alelucrod/Perfusion/1.Memoria/imágenes/marcar segunda casilla al instalar python.JPG

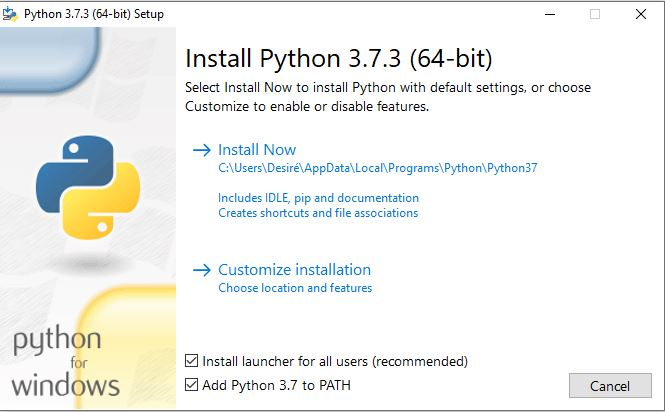
1.Memoria/imágenes/marcar segunda casilla al instalar python.JPG
