alelucrod/Perfusion/1.Memoria/Memoria Alberto/tfg_memoria_05.pdf

# Proyecto Fin de Grado Grado en Ingeniería de las Tecnologías Industriales

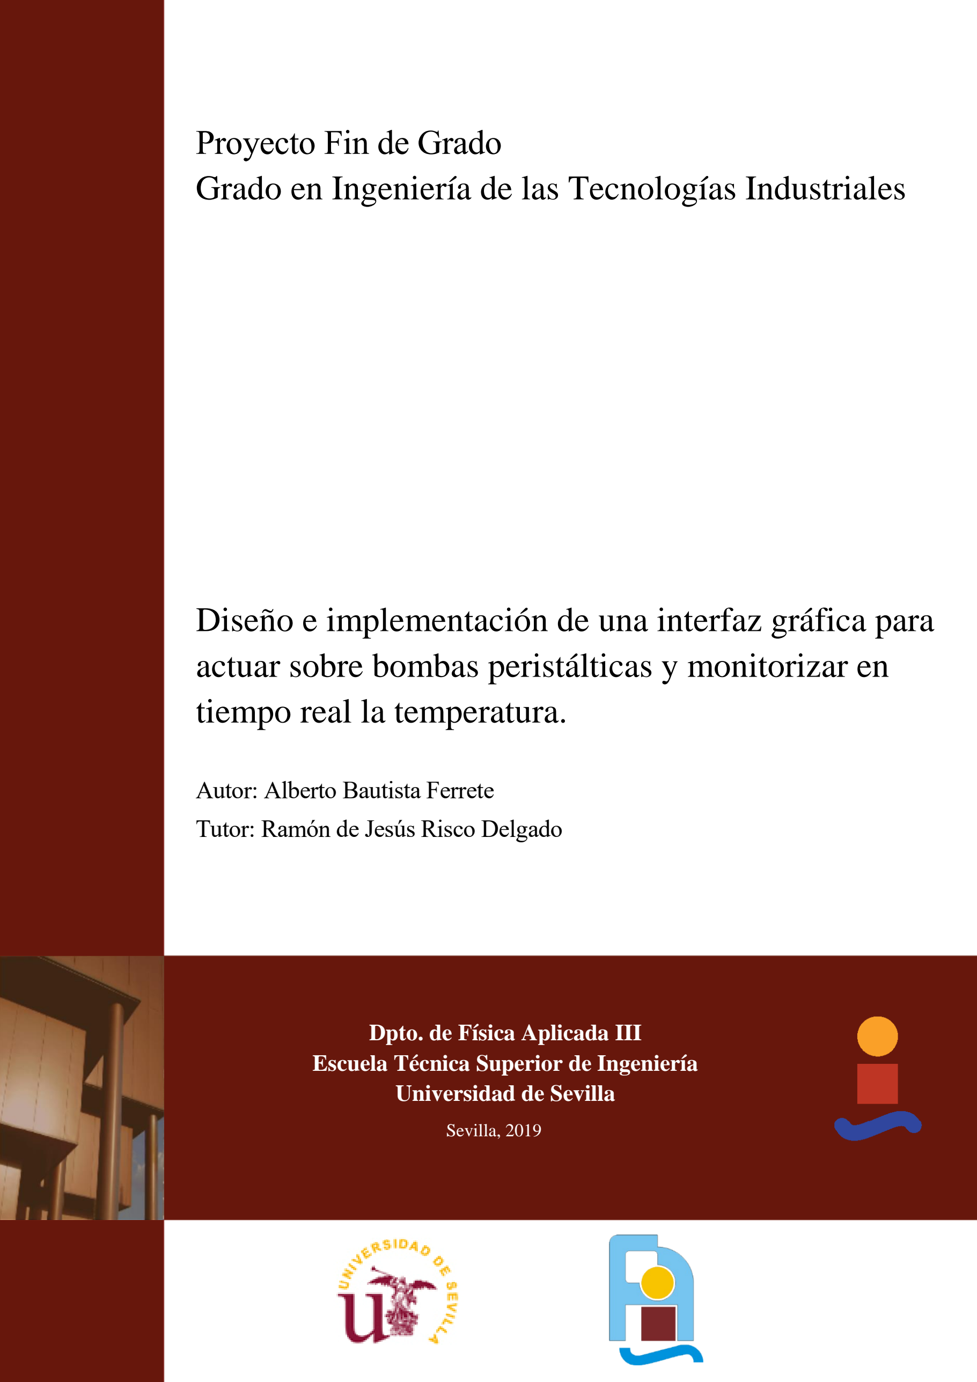
[picture p49: page 1]

Equation Chapter 1 Section 1

# Diseño e implementación de una interfaz gráfica para actuar sobre bombas peristálticas y monitorizar en

tiempo real la temperatura.

## Autor: Alberto Bautista Ferrete

## Tutor: Ramón de Jesús Risco Delgado

### Dpto. de Física Aplicada III Escuela Técnica Superior de Ingeniería Universidad de Sevilla

Sevilla, 2019

## Proyecto Fin de Grado Grado en Ingeniería de las Tecnologías Industriales

# Diseño e implementación de una interfaz gráfica para actuar sobre bombas peristálticas y

monitorizar en tiempo real la temperatura.

Autor:

Alberto Bautista Ferrete

Tutor:

Ramón de Jesús Risco Delgado

Profesor titular

## Dpto. de Física Aplicada III

## Escuela Técnica Superior de Ingeniería

## Universidad de Sevilla

Sevilla, 2019

Proyecto Fin de Grado: Diseño e implementación de una interfaz gráfica para actuar sobre bombas peristálticas y monitorizar en tiempo real la temperatura.

Autor: Alberto Bautista ferrete

Tutor: Ramón de Jesús Risco Delgado

El tribunal nombrado para juzgar el Proyecto arriba indicado, compuesto por los siguientes miembros:

Presidente:

Vocales:

Secretario:

Acuerdan otorgarle la calificación de:

Sevilla, 2019

El Secretario del Tribunal

A mis padres y hermano.

A mis amigos.

A N.P.J.D.G.P

# Agradecimientos

En primer lugar, me gustaría mencionar a Alejandro Lucas Rodríguez por su dedicación, enseñanza y gran paciencia que ha mostrado. Siempre ha estado al servicio de lo que necesitase y ha facilitado a elaboración de este trabajo.

También he de agradecer a Ramón Risco Delgado y al personal del laboratorio L4 de la ETSI por las facilidades y los servicios prestados a la hora de utilizar el laboratorio.

Durante todo el tiempo invertido durante mis estudios universitarios he aprendido conceptos de cada una de las materias que los diferentes profesores me han impartido, pero sobre todo me han formado como persona aportándome una gran madurez y una visión diferente del mundo ingenieril. A ellos también mi sincero agradecimiento.

Acabo estás líneas agradeciendo a mis padres el sufrimiento en silencio que han sabido llevar durante todos estos años, a mi hermano que siempre ha estado atento a mí y a mis amigos que me han visto sufrir pero que siempre han conseguido sacarme una sonrisa y evadirme en los momentos más duros de la carrera.

Alberto Bautista Ferrete

Sevilla, 2019

# Resumen

Con el siguiente trabajo se pretende ayudar y facilitar la experimentación con criopreservación al personal del laboratorio que utiliza un par de bombas peristálticas de interés en Medicina y Biotecnología mediante una interfaz gráfica.

Este proyecto es la renovación de uno existente que se ha venido utilizando en el laboratorio, pero que ha quedado obsoleto tecnológicamente ya que el software implementado sólo es capaz de ejecutarse en un sistema operativo antiguo y con un hardware muy limitado.

Con este fin, se propone como solución la creación de una interfaz gráfica de usuario que agilice las pruebas de laboratorio y sea interactiva para que los investigadores y alumnado no tengan que aprender conceptos informáticos complejos para poderla utilizar.

Entre las diferentes características que en él se pueden encontrar, destacan las siguientes especificaciones que debe de cumplir este trabajo fin de grado.

- Escalable: cualquier alumno que quiera mejorar este trabajo añadiendo nuevas funcionalidades puede hacerlo sin tener grandes conocimientos sobre software informático y electrónica.
- Moduralizado: en el ámbito de la electrónica se han utilizado dispositivos (módulos) independientes que pueden ser reemplazados y cuyas funcionalidades están separadas del resto, por lo que, si se estropea o se produce algún fallo en cualquiera de los módulos, no inutiliza a los demás.
- Software libre: no se ha utilizado ningún software ni licencias de pago del que no se tiene conocimientos para su uso.
- Amplia comunidad: al disponer de un software libre cualquier persona iniciada o que se esté iniciando en programación puede encontrar ayuda o soluciones por parte de la comunidad en foros. Siempre es mejor desarrollar conjuntamente que de forma independiente.

Bajo estas premisas se ha conseguido actualizar el sistema del que se disponía, adaptarlo a futuras mejoras y certificar su validez de funcionamiento.

Para llevarlo a cabo, se realizará el diseño y construcción de una placa electrónica capaz de recopilar un amplio espectro de temperaturas y, a su vez, actuar sobre el caudal de una sustancia líquida que fluye por una serie de bombas peristálticas.

A continuación, y ligado con lo anterior, se implementará un software con una interfaz gráfica que facilite la actuación sobre las bombas, la monitorización de las temperaturas y el cambio de parámetros.

Para finalizar, este trabajo fin de grado se ha elaborado de tal modo que cualquier alumno interesado en un tfg, con características similares a este, pueda continuar mejorando y actualizando la interfaz gráfica, implementando nuevas funcionalidades.

# Abstract

The following project is intended to help and facilitate experimentation with cryopreservation to laboratory staff using a pair of peristaltic pumps of interest in Medicine and Biotechnology through a graphic interface.

This project is the renovation of an existing one that has been used in the laboratory, but which has become technologically obsolete since the software implemented is only capable of running on an old operating system and with very limited hardware.

To this purpose, it is proposed the creation of a graphical user interface that speeds up laboratory tests and is making it interactive so that researchers and students would not have to study complex computer concepts in order to use it

Among the different characteristics that can be found in it, the following specifications about this TFG must be highlighted.:

- Scalable: any student who wants to improve this work by adding new features can do so without having great knowledge about computer and electronic software.
- Modified: in the field of electronics devices, which have been used that can be replaced and whose functionalities are separated from the rest, so if it breaks down or a fault occurs in any of the modules, it does not disable others.
- Free software: no software or paid licenses have been used for which there is no knowledge for its use.
- Large community: by having free software any person initiated or who is starting in programming can find help or solutions from the community in forums. It is always better to develop together than independently.

Under these premises it has been possible to update the system that was available, adapt it to future improvements and certify its operational validity.

To carry it out, an electronic board will be designed and constructed being capable of compiling a wide spectrum of temperatures and, in turn, acting on the flow rate of a liquid substance flowing through a series of peristaltic pumps will be carried out.

Related to what has been mentioned above, a software with a graphical interface will be also implemented to facilitates the operation on the pumps, the monitoring of the temperatures and the change of parameters.

Finally, this TFG has been developed in such a way that any student interested in a TFG, with similar characteristics to this, can continue improving and updating the graphic interface, idding new functionalities.

# Índice

Agradecimientos | ix
Resumen | xi
Abstract | i
Índice | iii
Índice de Tablas | v
Índice de Figuras | vii
Notación | ix
1 | Introducción | 1
1.1 Criopreservación | 1
1.2 | Objetivo | 1
2 | Hardware | 5
2.1 | Componentes | 5
2.1.1 | Raspberry Pi 3: modelo B+ | 5
2.1.2 | Módulo MCP4725 | 6
2.1.3 | Módulo relé de 2 canales | 7
2.1.4 | Buzzer | 8
2.1.5 | Termopar Adafruit MAX31856 tipo K | 8
2.1.6 | Bidireccional | 9
2.2 | Fabricación de PCB | 10
2.2.1 | Pruebas iniciales | 10
2.2.2 | Diseño | 10
2.2.3 | Elaboración del prototipo | 11
2.2.4 | Montaje de componentes y verificación de funcionamiento | 13
2.2.5 | Placa de Fábrica | 14
3 | Software | 15
3.1 | Configuración Raspberry Pi 3 B+ | 15
3.1.1 | Sistema Operativo | 15
3.1.2 | Conexión Raspberry Pi desde Windows® | 16
3.1.3 | Lenguaje de programación: Python | 19
3.1.4 | Selección de pines GPIO | 19
3.1.5 | Puesta en marcha de los componentes | 21
4 | Interfaz gráfica | 26
4.1 | Estructura | 26
4.1.1 | Software | 26
4.1.2 | Diseño | 27
4.1.3 | Funcionamiento | 30
5 | Conclusiones y líneas futuras | 34
5.1 | Conclusiones | 34
5.2 | Líneas futuras | 35

Anexos | 36
Anexo A: Códigos | 36
Código: test_general.py | 36
Código: perfusion_19.py | 42
Código: Plotter.py | 53
Anexo B: Planos de la PCB | 55
Esquemático | 55
Ruteado | 55
Circuitos impresos. | 56
Cara top | 56
Cara bottom | 56
PCB | 57
Cara top | 57
Cara bottom | 58
Anexo C: Datasheet | 59
Raspberry Pi 3 B+ | 59
MCP4725 | 59
Módulo rele de 2 canales | 59
Buzzer | 59
Termopar | 59
Módulo bidireccional | 59
Referencias | 61

# ÍNDICE DE TABLAS

Tabla 1: Configuración de los pines de la RPI3 | 20

# ÍNDICE DE FIGURAS

Figura 1: Bombas peristálticas del laboratorio. | 2
Figura 2: Raspberry Pi 3 B+ | 6
Figura 3: MicroSD | 6
Figura 4: Gota soldadura para la dirección del MCP4725 | 6
Figura 5: Módulo MCP4725 | 7
Figura 6: Modulo 2 relés. | 8
Figura 7: Buzzer | 8
Figura 8: Amplificador de termopar MAX31856 y de temperatura | 9
Figura 9: Convertidor de nivel lógico bidireccional de 3.3V a 5V | 10
Figura 10:Pruebas iniciales con protoboard. | 10
Figura 11: Imagen del diseño de la placa. | 11
Figura 12:Huela del componente MCP4725 | 11
Figura 13: Papel vegetal. | 12
Figura 14: Cara superior del diseño sobre papel vegetal. | 12
Figura 15:Placa fotosensible antes del corte. | 12
Figura 16:Placa fotosensible despues del corte. | 12
Figura 17: Insoladora | 12
Figura 18:Imagen PCB tras el revelado | 13
Figura 19: PCB tras el ataque químico. | 13
Figura 20: RPI3 y placa PCB finalizada. | 14
Figura 21: Logo de la empresa PCBWay. | 14
Figura 22: Imagen de Raspbian. | 15
Figura 23: Ventana del programa SD Card Formatter. | 15
Figura 24: Imagen del programa Win32 Disk Imager. | 16
Figura 25: Configuración del redireccionamineto de puertos mediante el router. | 17
Figura 26: Conexión a la RPI3 desde una red externa. | 18
Figura 27: Conexión a la RPI3 desde la misma red. | 18
Figura 28: Logo de Python. | 19
Figura 29: Distribución de pines GPIO de la RPI3 | 20
Figura 30: Configuración bus I2C. | 22
Figura 31: Mapa de direcciones del bus I2C | 22
Figura 32: Binding PyQt. | 26
Figura 33: Logo Qt Designer. | 26
Figura 34: Pestaña About de la GUI. | 27
Figura 35: Pestaña Tool and Test de la GUI. | 28
Figura 36: Botones módulo relé. | 28
Figura 37: Botones LEDs y Buzzer. | 28
Figura 38: Casillas y botones de las bombas. | 29
Figura 39: Casillas de lecturas de los termopares | 29
Figura 40: Pestaña Preferences de la GUI. | 29

Figura 41: Pestaña Overview de la GUI. | 30
Figura 42: Opciones al abrir perfusion_19.py | 30
Figura 43: Medidor de flujo de líquido (caudalímetro). | 35

# Notación

°C | Grados Celsius.
Cm | Centímetros.
CPU | Central Processing Unit (Unidad central de procesamiento).
cs | Centésimas de segundo.
DMSO | dimetilsulfóxido
GHz | Gigahercio.
GPIO | General Purpose Input/Output (Entrada/Salida de Propósito General).
GUI | Graphical User Interface (Interfaz gráfica de usuario).
LAN | Local Area Network (Red área local).
mA | Miliamperio.
ml | Mililitro.
mV | Milivoltios.
Mbps | Megabit por segundo.
PBS | Phosphate Buffered Saline
PCB | Printed Circuit Board (Placa de circuito impreso)
PID | Control Integral proporcional y derivativo
RPI3 | Raspberry Pi 3.
SO | Sistema Operativo.
SPI | Serial Peripheral Interface (bus serial).
USB | Universal Serial Bus (bus universal en serie).
vol. | Volúmenes

# 1 INTRODUCCIÓN

## 1.1 Criopreservación

a criopreservación es la técnica por la cual se disminuye a muy baja temperatura (entre -80ºC y -196ºC) células, tejidos, órganos y cuerpos, deteniendo su actividad metabólica pero no provocando su muerte.

Las células y tejidos que han sido criopreservados mantienen sus propiedades tras la descongelación, pero actualmente los órganos presentan la formación de hielo cuando se criopreservan y en su posterior descongelación. Esta formación de hielo produce dos problemas principales:

- El agua está presente en el cuerpo de los animales y como no puede ser de otra manera también en sus órganos. El agua de estos órganos se cristaliza por la parte extracelular y no por la parte intracelular, produciendo un desequilibrio osmótico aumentando la concentración de sales disueltas al disminuir la cantidad de agua líquida en ellos. Este problema pone en peligro la viabilidad de las células de los órganos a causa de la deshidratación.
- Durante la congelación se produce la formación de cristales de hielo. El hielo al ocupar un mayor volumen que el agua líquida provoca la presión sobre las células y causa un daño irreparable sobre la estructura interna de las células.

Una posible solución radica en el uso de crioprotectores. Su función es que no se produzca cristales de hielo durante el enfriamiento. Los crioprotectores tienen la habilidad de unirse al agua y la capacidad de reducir los efectos tóxicos de las altas concentraciones de sales ya que estos sustituyen el agua de la célula y consiguen mantener el equilibrio osmótico en ella.

Los crioprotectores son muy útiles en células aisladas o en tejidos, pero en los órganos existen diferentes células y cada una tiene sus propias propiedades de criopreservación por lo que utilizar un único crioprotector limita la recuperación de todas las células que forman los órganos.

## 1.2 Objetivo

En el siguiente proyecto se tiene como objetivo principal ayudar a conseguir la criopreservación de órganos mediante la actualización de los medios electrónicos e informáticos que se disponen en el laboratorio. Para ello, se ha pensado como solución la implementación de una interfaz gráfica en la que facilite el trabajo al/los usuario/s que realicen la experimentación en el laboratorio.

Lo primero que se debe realizar es un estudio del funcionamiento de los equipos con los que se realiza la experimentación. Concretamente los equipos sobre los que se va a implementar la interfaz gráfica son unas bombas peristálticas.

Una bomba peristáltica es un tipo de bomba hidráulica de desplazamiento positivo utilizada para hacer circular fluidos. Cada fluido, buffer fosfato salino (PBS) y dimetilsulfóxido (DMSO), se utiliza como crioprotector en cada bomba y estos circulan por unos tubos flexibles los cuales son comprimidos y descomprimidos. En cada bomba, esta acción se lleva a cabo por unos rodillos ligados a un rotor, que se encarga de comprimir el tubo consiguiendo mover los crioprotectores. El fluido crioprotector siempre avanzará a medida que la comprensión del rodillo vaya avanzando por el tubo. Además, en todo momento hay, al menos, un rodillo comprimiendo el tubo, lo cual evita que el líquido circule hacia atrás.

Durante la realización de este trabajo fin de grado, en el laboratorio se disponía de dos bombas peristálticas como las que se muestran en la figura. Una hacía circular PBS y la otra DMSO.

L

2 | Introducción


Figura 1: Bombas peristálticas del laboratorio.

# 2 HARDWARE

o es posible hacer realidad la monitorización (recopilación de información del entorno para su análisis) y el control (acciones de respuesta tras el análisis) sin la combinación y comunicación entre los distintos elementos físicos que conforman el hardware del proyecto. Tampoco es posible realizar un prototipo de PCB y que cumpla con las especificaciones la primera vez que se diseña. Por ello en los siguientes apartados y subapartados se pueden ver los diferentes componentes utilizados, la justificación de su uso y los pasos que se llevaron a cabo en el diseño, modelado, rectificaciones y montaje de la placa PCB antes de su correcto funcionamiento.

## 2.1 Componentes

En los apartados que vienen a continuación se describen los diferentes elementos físicos utilizados para poder hacer realidad la monitorización y actuación de las bombas peristálticas, así como la justificación de su uso y el coste económico de cada uno

### 2.1.1 Raspberry Pi 3: modelo B+

La comunicación entre el medio físico y el usuario para la recopilación de datos y la toma de decisiones se debe llevar a cabo mediante un ordenador. Para no tener siempre este dispositivo conectado cada vez que se requiera la utilización de las bombas peristálticas se ha optado por la utilización de una Raspberry pi. Concretamente se ha optado por el modelo B+ de la Raspberry Pi 3. No es más que un micro computador pensado para no tan altas prestaciones como los ordenadores que se pueden ver hoy en día. En él se puede cargar un sistema operativo desde la tarjeta Micro SD¹
, donde previamente se ha instalado dicho sistema operativo.

La Raspberry Pi 3 B+ para que funcione debe de estar alimentada con un cargador de 2500 mA y 5V

Entre sus especificaciones resaltan: un procesador más potente que funciona a 1.4 GHz, Bluetooth 4.2, 40 pines para la comunicación con el exterior y la posibilidad de trabajar cómodamente vía Wi-Fi. El resto de prestaciones técnicas aparecen en el siguiente listado:

- CPU + GPU: Broadcom BCM2837B0, Cortex-A53 (ARMv8) 64-bit SoC @ 1.4GHz
- RAM: 1GB LPDDR2 SDRAM
- Wi-Fi + Bluetooth: 2.4GHz y 5GHz IEEE 802.11.b/g/n/ac, Bluetooth 4.2, BLE
- Ethernet: Gigabit Ethernet sobre USB 2.0 (300 Mbps)
- GPIO de 40 pines
- 4 puertos USB 2.0
- Puerto CSI para conectar una cámara.
- Puerto DSI para conectar una pantalla táctil
- Salida de audio estéreo y vídeo compuesto
- Power-over-Ethernet (PoE)

Su precio es asequible para las buenas funcionalidades que ofrece. El coste de esta ha sido de 83,01€

1 La Raspberry Pi 3 B+ no trae memoria. Se la ha de incorporar mediante una Micro SD cuyo modelo y características aparecen en subapartado 2.1.1.1

N

Hardware


Figura 2: Raspberry Pi 3 B+

### 2.1.1.1 Micro SD

Como se ha mencionado en el apartado anterior hace falta insertar en la Raspberry una memoria para poder cargar el sistema operativo y poder trabajar en el proyecto.

Se ha optado por una tarjeta de memoria de 32 GB micro SD con una velocidad de lectura/escritura de hasta 100 MB/s para disparar y transferir rápido entre sus características más llamativas.

El coste de esta ha sido de 19 €.

Figura 3: MicroSD

### 2.1.2 Módulo MCP4725

El módulo MCP4725 (figura 5) es un convertidor de digital a analógico (DAC) de baja potencia, alta precisión, canal único y salida de voltaje de 12 bits con memoria no volátil (EEPROM). Es decir, mediante señales digitales de la Raspberry se puede actuar sobre el voltaje (analógico) y manipular las velocidades de las bombas peristálticas; por lo que se puede actuar sobre el caudal de dichas bombas.

El MCP4725 tiene una interfaz I2C fácil de usar que se puede configurar para usar una de las dos direcciones I2C ya que se dispone de dos módulos MCP4725 para actuar sobre cada una de las dos bombas peristálticas.

Las direcciones se establecen conectando dos de los tres pequeños electrodos de soldadura en la parte superior del módulo denominada “ADDR”. El pin central está conectado al pin de dirección A0 en el chip MCP4725. Al lado hay un pin GND y un pin VCC. Se utiliza una gota de soldadura para unir la tierra o el VCC al pin A0, por lo tanto, tirando a tierra a través de una resistencia de 10K o uniéndola a VCC.

Si el pin GND y el pin central están puenteados, el pin A0 está conectado a tierra y la dirección I2C predeterminada es 0x60. Si se desea cambiar la dirección puede poner la gota de soldadura uniendo el pin central y el pin VCC por lo que la dirección será la 0x61.

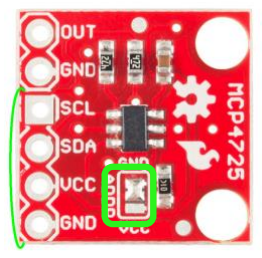
[picture p50: figure]

Figura 4: Gota soldadura para la dirección del MCP4725

Diseño e implementación de una interfaz gráfica para actuar sobre bombas peristálticas y monitorizar en tiempo real la temperatura.

También incorpora una memoria EEPROM que permite que mantenga el nivel de tensión incluso después de un corte de alimentación.

La tensión de alimentación del MCP4725 es de 2.7V a 5.5. La tensión máxima que puede proporcionar es VCC. Alimentado a una tensión de 5V sus 4096 niveles (12 bits) suponen una precisión de, aproximadamente, 1mV.

Se ha comprado 2 módulos, siendo el precio total por los dos de 8.79 €


Figura 5: Módulo MCP4725

### 2.1.3 Módulo relé de 2 canales

Estos interruptores permiten activar o desactivar otros componentes de alto voltaje o amperaje, como pueden ser las bombas peristálticas, con una pequeña señal proporcionada por la Raspberry Pi.

El módulo (ver figura 6) posee 2 relés de alta calidad, capaces de manejar cargas de hasta 250V/10A. Cada canal posee aislamiento eléctrico por medio de un optoacoplador y un led indicador de estado. Su diseño facilita el trabajo con Raspberry Pi. Este módulo Relay activa la salida normalmente abierta (NO: Normally Open) al recibir un "0" lógico (0 Voltios) y desactiva la salida con un "1" lógico (5 voltios).

Entre las cargas que se pueden manejar tenemos: bombillas de luz, luminarias, motores AC (220V), motores DC, solenoides, electroválvulas, calentadores de agua y una gran variedad de actuadores más. Se recomienda realizar y verificar las conexiones antes de alimentar el circuito, también es una buena práctica proteger el circuito dentro de un case.

Entre sus especificaciones técnicas se encuentran:

- Voltaje de Operación: 5V DC
- Señal de Control: TTL (3.3V o 5V)
- Nº de Relays (canales): 2 CH
- Modelo Relay: SRD-05VDC-SL-C
- Capacidad máx.: 10A/250VAC, 10A/30VDC
- Corriente máx.: 10A (NO), 5A (NC)
- Tiempo de acción: 10 ms / 5 ms
- Para activar salida NO: 0 Voltios
- Entradas Optoacopladas
- Indicadores LED de activación

Se ha utilizado un único módulo, siendo el precio por la compra de 3 de ellos de 9 €.

Hardware


Figura 6: Modulo 2 relés.

### 2.1.4 Buzzer

El buzzer (figura 7) es un instrumento que emite señales acústicas para dar un aviso. Se trata de un electroimán que hace oscilar una pequeña lámina de metal. Se utilizará para emitir una señal de alarma en caso de que se den unas condiciones adecuadas.

Especificaciones técnicas:

- Voltaje de Operación: 3.3V - 5V DC
- Tipo: Piezo eléctrico pasivo
- Incluye el transistor S8550
- Pines: VCC, GND y Señal

Se ha utilizado un único módulo, siendo el precio por 5 de ellos de 8 €


Figura 7: Buzzer

### 2.1.5 Termopar Adafruit MAX31856 tipo K

Un termopar²
es transductor que ofrece como salida una diferencia de potencial (del orden de los mV) en función de la diferencia de la diferencia de temperatura que se produce entre uno de los extremos de ≪medida≫ y otro de ≪referencia≫

2 Para más información sobre los termopares se recomienda visitar la web de la referencia número [8]

Diseño e implementación de una interfaz gráfica para actuar sobre bombas peristálticas y monitorizar en tiempo real la temperatura.

El amplificador para termopar MAX31856 (ver figura 8) digitaliza la señal de cualquier tipo de termopar. Los datos de salida se ofrecen en grados Celsius (°C). Posee una resolución de temperaturas de 0.0078125 °C, exhibe una precisión de medición de ±0.15 % y permite lecturas comprendidas entre -210 °C y 1800 °C (dependiendo del tipo de termopar: K, J, N, R, S, T, E y B), rango más que suficiente para las temperaturas que se manejan en este proyecto. Las entradas de termopar están protegidas contra sobretensiones de hasta ±45V. Sus características más relevantes son:
- Proporciona lecturas de temperatura de termopar de alta precisión.
- Incluye corrección automática de linealización para 8 tipos de termopares.
- ± 0.15% (máx., -20 ° C a + 85 ° C) Termopar de escala completa y error de linealidad.
- Resolución de temperatura de termopar de 19 bits, 0.0078125 ° C
- La compensación interna de la unión en frío minimiza los componentes del sistema
- ± 0.7 ° C (máx., -20 ° C a + 85 ° C) precisión de unión fría
- La protección de entrada de ± 45V proporciona un rendimiento robusto del sistema.
- El filtrado de rechazo de ruido de 50Hz / 60Hz mejora la información de pedido del rendimiento del sistema
- Paquete TSSOP de 14 pines

Se ha hecho uso de tres módulos amplificadores de termopar MAX31856 junto a sus respectivas sondas de temperatura para este proyecto. El motivo radica en la necesidad de monitorizar la temperatura del fluido crioprotector que circula por las bombas.


Figura 8: Amplificador de termopar MAX31856 y de temperatura

### 2.1.6 Bidireccional

Un convertidor de niveles lógicos bidireccional es capaz de bajar y subir señales a diferentes voltajes. Como la Raspberry que se ha utilizado trabaja a un nivel lógico de 3.3 V y algunos de los módulos utilizados requieren un nivel lógico de 5 V, surge la necesidad de utilizar este dispositivo electrónico para convertir las señales de 3.3 V a 5 V y así conseguir que funcionen todos los módulos.

Se ha hecho uso de un único módulo siendo el coste por cinco de ellos de 7€.

Hardware

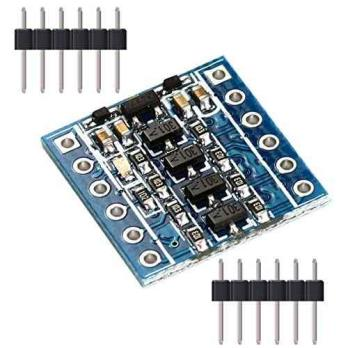
[picture p51: figure]

Figura 9: Convertidor de nivel lógico bidireccional de 3.3V a 5V

## 2.2 Fabricación de PCB

### 2.2.1 Pruebas iniciales

El primero de los pasos a realizar es la comprobación del correcto funcionamiento de todos los elementos antes descritos (MCP4725, módulo de dos relés, termopar MAX31856…). Para ello, y mediante la Raspberry Pi 3 B+, una placa protoboard y diferentes cables de conexión, se realizaron diferentes programas³

en Python⁴
(ver
figura 9). En el capítulo 3 y en el apéndice B se hace mayor hincapié en todo lo relacionado con la programación y elección de pines.


Figura 10:Pruebas iniciales con protoboard.

### 2.2.2 Diseño

El siguiente paso consiste en la elaboración del prototipo de placa mediante el programa de diseño EAGLE®⁵
.Los requisitos fundamentales que debe cumplir el diseño son los mostrados a continuación:
- Minimizar las dimensiones de la placa para que cupiesen todos los módulos utilizados, así como una zona reservada para los 40 pines de la Raspberry Pi 3 B+ y dos bornes de salida para los dos MCP4725.

3 Para ver con más detalle los programas realizados consulte el Anexo A: Códigos
4 Python es el lenguaje de programación utilizado como se describe en el capítulo 3: Software
5 EAGLE es el programa de diseño utilizado para realizar la PCB. Se describe con más detalle en el capítulo 3: Software y en el Anexo B: Planos

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

- Diseñar la huella de cada componente manteniendo las dimensiones originales y la distancia entre pines.
- Orientar los módulos de los termopares hacia el exterior de la placa para manipular las sondas cómodamente.
- Reservar sobre la parte externa de la placa una zona para los 40 pines de la Raspberry PI 3 B+ para que el fajín de pines no envuelva al resto de módulos y facilite la visión y manipulación de estos.
- Realizar la elaboración de la PCB a doble cara facilitando que ninguna de las pistas se pueda cruzar.

Teniendo en cuenta lo anterior mencionado se procedió a medir con el calibre el ancho, largo y distancia entre pines de cada componente para posteriormente dimensionar la placa con una superficie de 10x10 cm en la que entrasen todos los módulos que se utilizan (ver figura 11)


Figura 11: Imagen del diseño de la placa.


Figura 12:Huela del componente MCP4725

### 2.2.3 Elaboración del prototipo

Tras comprobar el correcto funcionamiento de cada componente y realizar el diseño mediante EAGLE se procede a forjar en el laboratorio y de forma casera la placa, para posteriormente verificar su buen funcionamiento y enviarla a una empresa para fabricarla de forma más precisa y mejorando la calidad que la elaborada manualmente.

El procedimiento que se ha llevado a cabo junto a los materiales necesarios han sido los siguientes:

- Impresión: una vez se haya hecho el diseño se imprime sobre papel vegetal la cara superior (top) y la cara inferior (bottom) de la placa. Es importante, a la hora de imprimir, que el fotolito tenga las mismas dimensiones que el diseño.


Figura 13: Papel vegetal.


Figura 14: Cara superior del diseño sobre papel vegetal.

- Mecanizado: sabiendo las dimensiones de la PCB (10x10 cm) se corta un trozo de placa fotosensible del mismo tamaño.

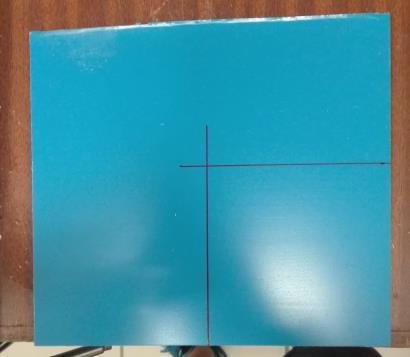
[picture p52: figure]

Figura 15:Placa fotosensible antes del corte. | Figura 16:Placa fotosensible después del corte.
- Insolación: las placas fotosensibles disponen de un plástico protector que evita que la placa se exponga a la luz y quede inutilizable. Retirado el plástico hay que colorar las hojas de impresión sobre la placa y asegurarse que las caras top y bottom del papel vegetal queden bien alineadas conforme al borde la placa anteriormente cortada. Este es un paso importante por lo que se recomienda tener cautela y fijar bien el papel vegetal a la placa. Posteriormente se introduce el conjunto en la insoladora donde se realiza el vaciado e insolación durante un tiempo aproximado de un minuto.


Figura 17: Insoladora
- Revelado: Se introduce la PCB en un recipiente de agua con sosa caustica. Poco a poco se verá como las pistas aparecen sobre la placa. Remover bien el recipiente ayudará a que el revelado salga mejor. Tras esto hay que lavar bien la placa con agua para limpiarla de la sosa caustica.

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


Figura 18:Imagen PCB tras el revelado
- Ataque químico: este es el paso más peligroso por lo que se recomienda estar bien protegido con gafas, guantes, bata y mascarilla debido a los vapores altamente nocivos que el ataque desprende. Se llena un recipiente con una parte de agua, agua oxigenada de 100 vol. y otra de salfuman (solución de ácido clorhídrico) hasta que la placa quede sumergida. Pasado tres de minutos se puede sacar la PCB del recipiente (evitando el contacto directo con el ácido) y revisar que se ha oxidado toda la parte de la PCB donde no hay pistas. A continuación, se limpia la placa nuevamente con agua y tras esto se frota con acetona y un estropajo no muy abrasivo la placa para quitar la película fotosensible que cubre las pistas y así dejar el cobre al aire. Por último, se limpia con acetona para eliminar los posibles minerales que contuviera el agua y la secamos bien.

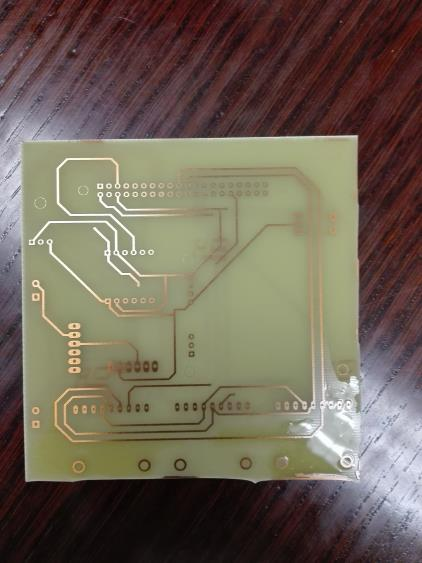
[picture p53: figure]

Figura 19: PCB tras el ataque químico.
- Taladrado: con un taladro y una broca de 0.7 mm se realizan todos los agujeros donde se introducirán los pines de los componentes y las vías. Hay que tener cuidado a la hora de taladrar ya que la broca es tan fina que puede llegar a romperse fácilmente.
- Soldadura con estaño: soldar cada uno de los componentes es una tarea que requiere paciencia y precaución. Se han seguido los pasos del siguiente tutorial⁶ para realizar una buena soldadura de los módulos

### 2.2.4 Montaje de componentes y verificación de funcionamiento

Realizada la PCB se coloca cada uno de los componentes sobre los pines de la placa siguiendo la orientación del diseño. Luego se comprueba el correcto funcionamiento de cada módulo mediante un programa denominado perfusión_19.py⁷ de verificación realizado en Python.

6 https://teslabem.com/nivel-basico/como-soldar-un-pcb/
7 Se puede ver en detalle el código y explicación en el anexo A: Códigos

Hardware


Figura 20: RPI3 y placa PCB finalizada.

### 2.2.5 Placa de Fábrica

Para finalizar y una vez comprobado todos los pasos anteriores se podrá enviar el diseño a una empresa para que fabriquen la PCB con mayor precisión y calidad. También habrá que verificar que esta placa funcione perfectamente. Se recomienda enviar la placa para su fabricación a la empresa PCBWAY© ya que ofrece la posibilidad de enviar el diseño de la PCB vía online.⁸

Figura 21: Logo de la empresa PCBWay.

8 https://www.pcbway.es/

# 3 SOFTWARE

a comunicación entre la Raspberry y los diferentes módulos no se lleva a cabo sola. Requiere de un conjunto de programas y rutinas que son las encargadas de hacer posible que la computadora (en este proyecto la RPI3) logre realizar las diferentes tareas que se especifican en este trabajo.

Debido a los motivos que se acaban de comentar, en este capítulo se describe en profundidad como se ha conseguido establecer una comunicación entre la computadora y los módulos; desde programas utilizados hasta librerías y códigos que se han implementado.

## 3.1 Configuración Raspberry Pi 3 B+

### 3.1.1 Sistema Operativo

El sistema operativo (SO) que se va a utilizar Raspbian, concretamente la versión 4.19.42-v7+. Raspbian es una distribución de GNU/Linux® basada en Debian lanzada para Raspberry Pi. Su elección se debe al ser un sistema abierto y gratuito de Linux® junto a la facilidad de conexión con los pies de la Raspberry GPIO.

Figura 22: Imagen de Raspbian.
Para su instalación se ha descargado la versión nombrada anteriormente desde la web de Raspberry⁹

Realizada la descarga, el archivo imagen se copia en la tarjeta microSD mencionada en el subapartado 2.1.1.1. Pero antes cabe mencionar que la tarjeta microSD ha de ser formateada mediante el programa SD Card Formatter®. Con este programa se consigue restaurar los 32 GB completos en una única partición teniendo la otra inutilizada. Con formatearla en “Quick format” será suficiente.


Figura 23: Ventana del programa SD Card Formatter.
Como se ha utilizado Windows® para descargar Raspbian se ha necesitado un programa adicional como

9 https://www.raspberrypi.org/downloads/raspbian/

L

Software

Win32DiskImage® para copiar el archivo imagen de Linux en la tarjeta Se deja en el capítulo Referencias en enlace web [10] donde se explica cómo utilizar este programa de forma satisfactoria. Tras ello, se introduce la tarjeta micro SD en la Raspberry y se tiene preparada para su utilización.


Figura 24: Imagen del programa Win32 Disk Imager.

### 3.1.2 Conexión Raspberry Pi desde Windows®

Trabajar desde Windows® es más rápido que trabajar sobre el SO instalado en la RPI3. Además de la comodidad de trabajar, comunicar y transferir archivos de forma inalámbrica. Es por ello que todos los códigos elaborados y diseño de la interfaz gráfica (GUI) se han realizado en un PC con Windows® y posteriormente se han copiado los archivos en la RPI3. El problema reside en la forma de comunicar el PC con la RPI3 de forma inalámbrica y segura. La solución está en el protocolo SSH.

El protocolo SSH permite comunicaciones seguras mediante una arquitectura cliente/servidor entre dos sistemas (en este proyecto PC(cliente) y RPI3 (servidor)) y ofrece a los usuarios conectarse a un host de forma remota. La elección de este protocolo se debe a estas características entre otras:

- El cliente puede verificar que está conectado al mismo servidor al que se conectó anteriormente.
- El cliente transmite su información de autenticación al servidor usando una encriptación de 128 bits.
- Todos los datos enviados y recibidos se transfieren por medio de una encriptación de 128 bits, siendo extremadamente difícil de descifrar y leer.

Como primer paso se debe habilitar SSH en la RPI3. Para ello se crea un fichero sin extensión llamado SSH en la partición denominada “boor” en la microSD. Luego para la conexión de la RPI3 a la red de la universidad se dio acceso desde el exterior solicitando una IP pública vinculada a una roseta del laboratorio con la instalación de un router para manejar los puertos de entrada/salida. Posteriormente se solicitó la apertura de puertos en el firewall perimetral de la universidad para conceder acceso desde el exterior para el uso del protocolo SSH RDP. La IP pública del laboratorio es hertz.us.es.

Existe un problema a la hora de transferir datos mediante el protocolo de comunicación SSH desde una IP privada hacia la IP privada de la universidad. Por seguridad todos los puertos están bloqueados (incluido el puerto 22 que es el encargado de la comunicación SSH) y vigilados por el firewall. Para poder realizar la comunicación habría que abrir el puerto 22, cosa dificultosa. Aunque existe un método denominado Port Forwading (redireccionamiento de puertos), el cual permite acceder desde el exterior a un puerto de una IP privada dentro de una LAN redirigiendo los datos por un puerto abierto mediante el router.

En este proyecto para tener acceso al puerto 22 (encargado del protocolo SSH) se solicitaron puertos a la universidad y se configuró el router para redirigir los datos por el puerto 8857. De esta manera desde cualquier red externa puede tener acceso a la RPI3 conectada a la red del laboratorio de la universidad mediante el

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

redirecionamiento del puerto 8857 al 22 de la propia RPI3

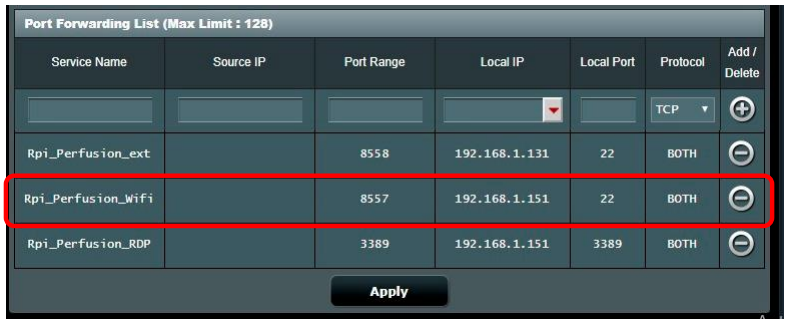
[picture p54: figure]

Figura 25: Configuración del redireccionamiento de puertos mediante el router.

Para realizar la conexión entre PC y RPI3 para transferir archivos se ha elegido el programa SSH Client®, descargado de su página web¹⁰. Su elección se debe a las siguientes características:

- Transferencia de archivos por SFTP.
- Capacidad conexión escritorio remoto.
- Reconexión automática en caso de caída de la conexión.

Una vez instalado el programa la conexión a la RPI3 resulta sencilla. Hay que distinguir dos casos:

- Conexión desde una red externa (p.e: conexión desde el hogar del usuario hacia el laboratorio): En la pestaña “Login” en el capo “Host” indicar la dirección IP pública del laboratorio hertz.us.es y en el campo Port, escribir el puerto 8557. Como “Username” y “Password” se ha de escribir pi y raspberry respectivamente.

10 https://www.bitvise.com/ssh-client-download

Software


Figura 26: Conexión a la RPI3 desde una red externa.

- Conexión desde la misma red (p.e: todos los dispositivos conectados a la red del laboratorio): Si se trabaja dentro de la misma red no hace falta habilitar puertos. En la pestaña “Login” en el capo “Host” indicar la dirección IP que el router proporciona a la RPI3 192.168.1.151 y en el campo “Port”, escribir el puerto 22. Como “Username” y “Password” se ha de escribir pi y raspberry respectivamente.


Figura 27: Conexión a la RPI3 desde la misma red.

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

Si todo se ha realizado correctamente cuando se pulse sobre “Log in” saldrá una ventana de línea de comandos y otra de SFTP.

NOTA 1: Si se ha conectado por primera vez la placa en la línea de comandos se deben ejecutar los siguientes comandos, aceptando las preguntas que se hagan durante el proceso:

sudo apt-get update

sudo apt-get upgrade

NOTA 2: Para poder utilizar el escritorio remoto desde Windows® se debe instalar el siguiente paquete desde la línea de comandos.

sudo apt-get install xrdp

### 3.1.3 Lenguaje de programación: Python

Python® es un lenguaje de programación multiplataforma (Windows, Linux, Mac) orientada a objeto. Contiene una sintaxis legible, fácil de interpretar y aprender por parte del programador. Es de código abierto, con licencia GNU.

Existen una amplia variedad de paquetes instalables con licencia libre (bibliotecas) y una gran comunidad activa en internet donde se puede encontrar códigos de ejemplos o preguntar en los foros para obtener ayuda.

Python no tiene una librería gráfica, pero mediante PyQt se puede crear interfaces gráficas multiplataforma. PyQt es un biding (adaptación de una biblioteca para ser utilizada en un lenguaje de programación distinto como es Python) de la librería gráfica Qt para el lenguaje de Python®.

Los motivos expuestos anteriormente hacen a Python el mejor lenguaje de programación para este proyecto. Su descarga es gratuita a través de su página web¹¹. Se ha instalado sobre la RPI3 la versión Python 3.5.3 de julio 2017 siendo el entorno de desarrollo Python 3.5 IDLE.


Figura 28: Logo de Python.

### 3.1.4 Selección de pines GPIO

En el capítulo 2.1.1 una de las características de la RPI3 era que proporcionaba 40 pines GPIO de carácter general donde la gran mayoría son utilizados como entradas y salidas digitales y algunos son utilizados con una funcionalidad específica. Los pines GPIO de la RPI3 se estructuran según la siguiente distinción de colores:

- Amarillo: Alimentación a 3.3V.
- Rojo: Alimentación a 5V.
- Naranja: Entradas / salidas de propósito general. Pueden configurarse como entradas o salidas. Tener presente que el nivel alto es de 3.3V y no son tolerantes a tensiones de 5V.
- Gris: Reservados.
- Negro: Conexión a GND o masa.

11 https://www.python.org/downloads/

Software

- Azul: Comunicación mediante el protocolo I2C para comunicarse con periféricos que siguen este protocolo.
- Verde: Destinados a conexión para UART para puerto serie convencional.
- Morado: Comunicación mediante el protocolo SPI para comunicarse con periféricos que siguen este protocolo.

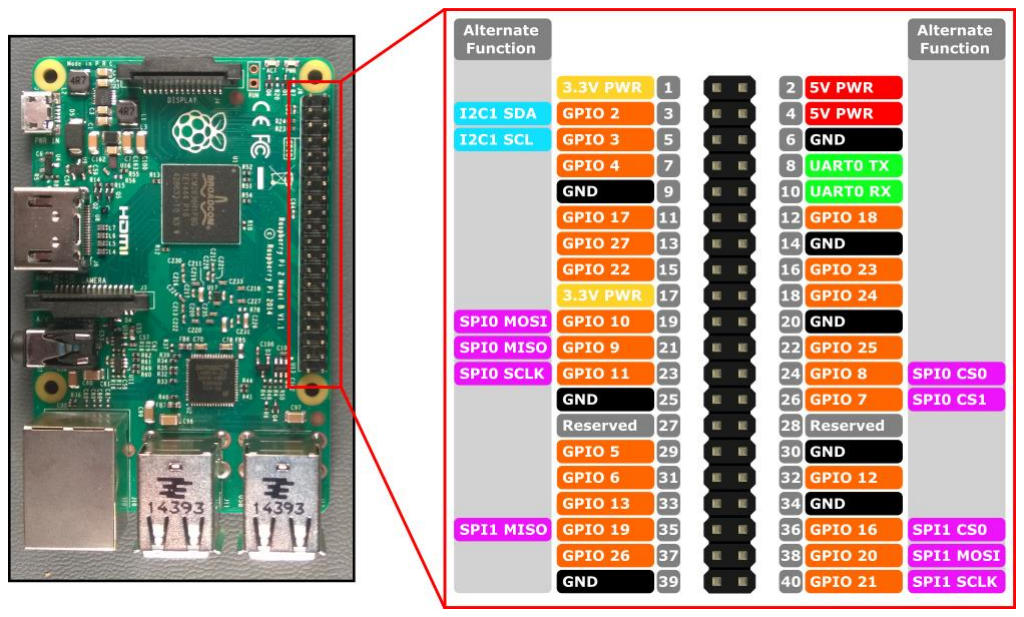
[picture p55: figure]

Figura 29: Distribución de pines GPIO de la RPI3

En este proyecto se han elegido los GPIO recogidos en la tabla que se observa a continuación para conectar y comunicar los diferentes módulos con la RPI3:

Tabla 1: Configuración de los pines de la RPI3

Módulos | Pines elegidos | Pines donde la señal se adapta de 3.3V a 5V

MCP4725_a

SCL: GPIO 3
SDA: GPIO 2
VCC: 3.3V | ✓
GND(x2)¹²: Cualquier pin
GND

MCP4725_b

SCL: GPIO 3
SDA: GPIO 2
VCC: 3.3V | ✓
GND (x2): Cualquier pin GND

Módulo Relé

Relé_1: GPIO 22
Relé_2: GPIO 27
VCC: 3.3V | ✓
GND: Cualquier pin GND

Buzzer

GPIO 18
VCC: 3.3V | ✓
GND: Cualquier pin GND

12 X2 significa que el módulo MCP4725 contiene dos pines a tierra GND.

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

Termopar_1

SCLK: GPIO 11
SDI: GPIO 10
SDO: GPIO 9
CS: GPIO 8
VCC: 3.3V
GND: Cualquiera de los pines GND

Termopar_2

SCLK: GPIO 11
SDI: GPIO 10
SDO: GPIO 9
CS: GPIO 8
VCC: 3.3V
GND: Cualquiera de los pines GND

Termopar_3

SCLK: GPIO 11
SDI: GPIO 10
SDO: GPIO 9
CS: GPIO 8
VCC: 3.3V
GND: Cualquiera de los pines GND

### 3.1.5 Puesta en marcha de los componentes

Antes de la realización de la interfaz gráfica se ha de comprobar el funcionamiento de cada uno de los módulos utilizados.

Una de las malas prácticas en la programación es no hacer códigos para testear la funcionalidad de cada módulo por separado. Por ello siguiendo esta recomendación, en este capítulo se explica cómo se ha elaborado cada uno de los códigos unitarios que hacen funcionar a cada módulo de forma correcta. Así, si la interfaz gráfica falla, se puede ejecutar estos códigos para dictaminar con más acierto y facilidad dónde puede haber un fallo en el caso de que surja

No se muestra el código al completo, sólo las líneas más importantes y las librerías utilizadas. En el caso de que se quiera consultar los códigos completos se recomienda mirar el apartado ANEXO A: CÓDIGOS.

### 3.1.5.1 Código MCP4725

Como el MCP4725 es un convertidor Digitat-Analógico (DAC), el objetivo del código de comprobación consiste en ir aumentando de forma lineal los valores de tensión a la salida (de 0V a 5V) mediante un bucle en el que se aumenta linealmente los dígitos de entrada (de 0 a 4095) para posteriormente decrementar de la misma forma los valores de salida (de 5V a 0V) mediante otro bucle en el que los dígitos de entrada disminuyen (de 4095 a 0).

Los dígitos de entrada varían entre 0 y 4095; correspondiendo el valor 0 a 0V y el valor 4095 a 5V. Para conocer un valor intermedio de la salida de tensión basta con realizar el siguiente cálculo:

VOUT[V] =

Dígito entrada (0 ÷ 4095)
4095 | ∙ 5V

Si se quiere cumplir el objetivo mencionado anteriormente es necesario la instalación de la librería del MCP4725 (es suficiente realizarlo sólo una vez y ya se ha realizado en este proyecto). Para ello en la línea de comandos se ejecuta:

sudo pip3 install adafruit-circuitpython-mcp4725

Software

Una vez instalada la librería se puede dar uso en Python importándola con el comando:

import adafruit_mcp4725

Sin duda todo lo realizado hasta ahora no cobra sentido si no existiese el bus I2C en la Raspberry PI 3 para comunicarse con el módulo MCP4725. Mediante el I2C la Raspberry puede compartir información con los módulos (en este caso los dos MCP4725) mediante las líneas de conexión SDA (Serial Data Line) y SCL (Serial Clock Line). Para poder utilizar este bus primero hay que activarlo:

Desde el terminal ejecutar: sudo raspi-config

Seleccionar la opción 5: “Interfacing Options”

Seleccionar la opción P5: “I2C”

Elegir “YES”

Acto seguido aparecerá una ventana en la que se solicita al usuario confirmación para finalizar la acción. Se deberá seleccionar “OK” y pulsar a continuación “Finish”


Figura 30: Configuración bus I2C.

Activado el bus I2C, el siguiente paso es saber qué dirección contiene cada MCP4725 para que la RPI3 sepa a qué MCP4725 de los dos tiene que mandar órdenes en un instante concreto.

Saber qué direcciones tiene cada MCP4725 es tan sencillo como ejecutar en el terminal:

sudo i2cdetect –y 1

En el mapa de direcciones que aparece se puede contemplar las direcciones que se les ha asignado a cada MCP4725 que serán utilizadas en el código de Python para diferenciar ambos módulos.

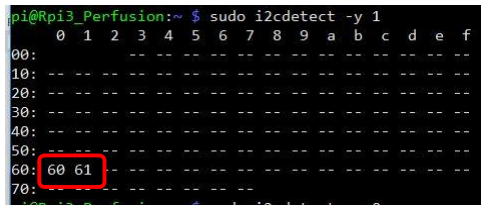
[picture p56: figure]

Figura 31: Mapa de direcciones del bus I2C
Realizada la configuración del bus I2C ya sí se puede realizar un código funcional para el MCP4725. Como se ha mencionado anteriormente se variará la tensión de salida que genera el módulo. Las líneas más relevantes del

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

código se muestran a continuación junto a una breve explicación:

Librerías necesarias:

import board

import busio

import time

import adafruit_mcp4725

Inicialización del bus I2C:

i2c = busio.I2C(board.SCL, board.SDA)

Inicialización de un MCP4725 concreto con su dirección

dac = adafruit_mcp4725.MCP4725(i2c, address=0x61)

### 3.1.5.2 Código Relé

El código del relé se basa en el encendido y apagado de cada uno de los dos relés dentro de un bucle continuo. Las líneas a destacar son las siguientes.

import Rpi.GPIO as GPIO → Con esta línea se importa la librería para controlar los GPIOs y se le asocia una forma más corta para referirse a ella. A partir de este momento si se quiere ejecutar una función deberemos escribir GPIO. ____ y la función que se requiera.

GPIO.setmode(GPIO.BCM) → se establece el sistema de numeración forma desordenada. Este es con la referencia del SoC System On Chip, que son los GPIOs íntegramente (en la imagen 29 los que se denominan GPIO).

RelayPin_1 = 27 → se establece el GPIO a utilizar por el relé .1

RelayPin_2 = 22 → se establece el GPIO a utilizar por el relé 2.

GPIO.setup(RelayPin_1, GPIO.OUT) → Configuración de GPIO como salida

GPIO.setup(RelayPin_2, GPIO.OUT) → Configuración de GPIO como salida

GPIO.output(RelayPin_1, True) → Apagado del relé 1

GPIO.output(RelayPin_1, False) → Encendido del relé 1

GPIO.output(RelayPin_2, True) → Apagado del relé 2

GPIO.output(RelayPin_2, False) → Encendido del relé 2

### 3.1.5.3 Código Buzzer

El código del buzzer no es más que la reproducción de uno de los 5 tonos que el usuario elige por la entrada del teclado. Cabe destacar las siguientes líneas de código:

import Rpi.GPIO as GPIO → Con esta línea se importa la librería para controlar los GPIOs y se le asocia una forma más corta para referirse a ella. A partir de este momento si se quiere ejecutar una función deberemos escribir GPIO. ____ y la función que se requiera.

class Buzzer(object) → Se crea una clase (Buzzer) con tipos de datos creados por el programador.

Software

GPIO.setmode(GPIO.BCM) → se establece el sistema de numeración forma desordenada. Este es con la referencia del SoC System On Chip, que son los GPIOs íntegramente (en la imagen 29 los que se denominan GPIO).

self.buzzer_pin = 18→ se establece el GPIO a utilizar por el buzzer

GPIO.setup(self.buzzer_pin, GPIO.OUT) → Configuración de GPIO como salida

def buzz(self,pitch, duration) →Se crea la función buzz con la que se origina el tono en función de la melodía que haya introducido el usuario por teclado y la duración de cada melodía. Está compuesto por:

period = 1.0 / pitch → Cálculo del periodo.

delay = period / 2 →Tiempo de la mitad de un periodo.

cycles = int(duration * pitch) →Cálculo del número de ciclos. →

En un bucle desde 0 hasta el número de ciclos:

GPIO.output(self.buzzer_pin, True) →Encendido del buzzer (emite un sonido.)

time.sleep(delay) →Espera con el buzzer encendido.

GPIO.output(self.buzzer_pin, False) →Apagado del buzzer (se deja de emitir sonido)

time.sleep(delay) → Espera con el buzzer encendido.

Una vez elaborada la función que emite la melodía de forma genérica se crea la función en la que se elige, en función de lo que el usuario haya introducido por teclado (tune), la melodía a sonar:

def play(self, tune)

### 3.1.5.4 Código termopares MAX31856

El código de los termopares consiste en cuatro lecturas de cada termopar cada segundo, mostrando como lecturas dos valores concretos:

- temperatura detectada al final de la sonda del termopar (temp).
- temperatura del chip del microcontrolador (internal).

El código de cada termopar es similar, diferenciándose entre ellos con las designaciones numéricas 1, 2 y 3. Para este módulo existe una librería que ha de ser instalada e importada denominada “Adafruit_MAX31856” (con hacerlo una vez es suficiente y ya se ha realizado en la RPI3). Para la comunicación entre la RPI3 y los módulos de termopares se debe habilitar el bus SPI. Este bus permite encadenar los termopares desde un solo set de pines, asignando a cada chip un pin distinto de Chip Select.

Las líneas más importantes del código de los termopares son las siguientes:

from Adafruit_MAX31856 import MAX31856 as MAX31856→Importa la librería del módulo MAX3856 para su uso.

software_spi_1 = {"clk": 11, "cs": 7, "do": 9, "di": 10} →Configura la comunicación SPI del termopar 1 (Similar para el resto de termopares, cambiando los valores de “cs” por 8 y 12 respectivamente.)

sensor_1=MAX31856(software_spi=software_spi_1,tc_type=MAX31856.MAX31856_ K_TYPE) → Establece la configuración del termopar 1 y le asigna el tipo K.

temp = sensor_1.read_temp_c() → Lectura de la temperatura al final de la sonda.

internal | = | sensor_1.read_internal_temp_c() → Lectura de la temperatura del
microcontrolador.

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

time.sleep(1.0) → Espera de un segundo entre lectura y lectura.

### 3.1.5.5 Código test general

Si se desea se puede ejecutar cada uno de los códigos por separado, pero se ha elaborado un código de testeo general en el que se ejecuta el código de cada uno de los módulos en secuencia cíclica para facilitar al usuario su uso en caso de fallo.

La secuencia seguida por el programa es:

- Encendido y apagado de los relés.
- Reproducción melodía del buzzer.
- Cuatro lecturas de cada uno de los tres termopares.
- Variación de la tensión del MCP4725

El programa completo se denomina test_general.py y se puede encontrar en el capítulo ANEXO A: CÓDIGOS.

Interfaz gráfica

# 4 INTERFAZ GRÁFICA

na interfaz gráfica de usuario (GUI) es un software a través del cual un usuario interactúa con el software de la computadora, como el SO, para mostrar información y controles de usuarios, mediante la utilización de menús, iconos, ventanas y otras representaciones de indicadores visuales. Una de sus ventajas es que facilita al usuario la comunicación con el SO de una computadora, siendo más dinámico y visual la ejecución de los códigos, frente a la interfaz de línea de comandos basada en texto. Por ello el usuario que la utilice no requiere de grandes conocimientos informáticos si sólo quiere usarla.

## 4.1 Estructura

### 4.1.1 Software

Existen varios programas para realizar una interfaz gráfica como Tkinter o WxPython, pero para este proyecto PyQt ha sido el elegido. PyQt es una adaptación de la biblioteca gráfica Qt para el lenguaje de Python. Con él se puede desarrollar aplicaciones con un entorno gráfico. Concretamente se ha utilizado la versión más actual: PyQt5.

Figura 32: Binding PyQt.

Para realizar visualmente la interfaz gráfica se pueden tomar dos vías:

- Programación en Python con PyQt5.
- Qt Designer.

En este proyecto se ha optado por Qt Designer, una herramienta de Qt para diseñar y construir interfaces gráficas a través de Widgets (botones, cuadro de textos, ventanas). Su elección se debe a la facilidad, dinamismo e interactividad para poder crear, dimensionar y modificar la interfaz al gusto del usuario. Además, una vez diseñada, se puede exportar a un archivo “.ui”, el cual se puede pasar a un archivo de Python “.py”.

Figura 33: Logo Qt Designer.

El último programa que se ha requerido ha sido PyQtGraph. Este es una biblioteca de gráficos e interfaz de usuario para Python. Con PyQtGraph se consigue mostrar gran cantidad de datos en tiempo real y mostrarlos

U

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

sobre una gráfica. Es ideal para la monitorización de la temperatura medida por los tres termopares y se asocia bien con el programa de diseño Qt Designer.

Cada uno de los programas han sido instalados en la RPI3, por lo que no hace falta volverlos a instalar¹³

### 4.1.2 Diseño

La realización del diseño de la interfaz gráfica se ha realizado mediante el programa Qt Designer. En este subcapítulo se describirá todos los aspectos de dicha interfaz gráfica como: dimensiones, ventanas, botones, displays y ventana gráfica.

Cabe señalar que no todos los widgets¹⁴ que componen la interfaz gráfica tienen funcionalidad, es decir puede haber botones o cuadros combinados que hagan referencia a un dispositivo, GPIO o direcciones pero que no estén vinculados a la RPI3, careciendo de función en la interfaz gráfica. Estos se han implementado para dejar el proyecto abierto a posibles mejoras.

La interfaz se ha diseñado con una dimensión de 800x500 píxeles. En ella se puede visualizar diferentes pestañas en las que se muestran las diferentes funciones. Empezando desde la pestaña derecha hacia la izquierda se observan:

- About: esta pestaña contiene información acerca de la interfaz gráfica como quién la ha diseñado, por quién ha estado supervisada durante su elaboración, softwares utilizados, fecha de realización, departamento que supervisa el proyecto, etc.


Figura 34: Pestaña About de la GUI.

- Tool and Test: en esta pestaña el usuario encuentra diferentes herramientas con las que puede interactuar con el sistema de las bombas realizando diferentes pruebas que se especifican a continuación:

13 En el apartado de referencias se muestran las webs en las que se han descargado todos los programas.
14 Widgets se entiende como el conjunto de botones, cuadro de textos, ventanas y cuadros combinados que forman la interfaz gráfica.

Interfaz gráfica


Figura 35: Pestaña Tool and Test de la GUI.

- Relay 2 Channel Module: la interfaz dispone de 4 botones en los que el usuario puede encender (Turn ON) y apagar (Turn OFF) los dos relés.


Figura 36: Botones módulo relé.

- LEDs and Buzzer: En esta sección el usuario encuentra cuatro bonotes de los cuales sólo el botón del buzzer está operativo. Al pulsar sobre él sonará una melodía a modo de aviso. El resto de botones están puesto sobre la interfaz a modo de aviso para algún evento, pero carecen de funcionalidad en este proyecto dejándolo como posible mejora.


Figura 37: Botones LEDs y Buzzer.

- DAC MCP4725: esta sección es la encargada de interactuar con las bombas peristálticas. Contiene tres casillas, donde el usuario puede introducir por teclado valores digitales entre 0 y 4095, y tres botones (Write Voltage), donde al ser pulsados se envía una señal analógica entre 0 y 5 V (según el valor digital introducido en la casilla correspondiente y la fórmula del subapartado 3.1.5.1) a las bombas peristálticas. Se ha diseñado para tres bombas, en el caso

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

de que en un futuro se quiera añadir una nueva bomba peristáltica, pero actualmente sólo las dos primeras casillas y botones, empezando desde arriba, están operativas.


Figura 38: Casillas y botones de las bombas.

- ThermoCouple: en el caso de que se quiera conocer el valor de temperatura de cualquiera de los tres termopares, el usuario dispone de tres displays donde se muestran las lecturas de cada uno de los termopares en un instante concreto cada vez que se pulse el botón (Get It!).


Figura 39: Casillas de lecturas de los termopares

- Preferences: esta pestaña se ha añadido como futura mejora. Se ha diseñado para que en un siguiente proyecto se pueda cambiar la configuración de cada uno de los módulos desde la interfaz gráfica y no mediante la programación. En ella se puede cambiar:
- Cambiar la asignación de pines de cada módulo.
- Cambiar la dirección del protocolo I2C de cada MCP4725.
- Seleccionar el tipo de termopar: K, J, N, R, S, T, E y B.


Figura 40: Pestaña Preferences de la GUI.

Interfaz gráfica

- Overview: en esta pestaña el usuario puede encontrar la monitorización de las temperaturas, medidas en grados Celsius, mediante una gráfica en tiempo real, medida en centésimas de segundo (cs), para visualizar los cambios de temperaturas que se puedan producir durante la experimentación.

Cabe mencionar que los valores de temperatura del eje vertical de la gráfica cambian automáticamente, amoldándose a los valores máximos y mínimos que tengan los termopares durante un intervalo de tiempo. Aparte se ha añadido bajo la gráfica una leyenda a color para facilitar el reconocimiento de cada termopar al usuario que utilice la interfaz gráfica.

Se ha añadido unos botones (STOP y START) en el caso de que se quiera parar la gráfica en un momento concreto. En este proyecto no tienen función, pero se dejan diseñados como posible mejora.


Figura 41: Pestaña Overview de la GUI.

### 4.1.3 Funcionamiento

La interfaz gráfica se visualiza mediante la ejecución del código perfusión_19.py que se puede encontrar en la ruta alberto/gui_code/pyqt5_gui. Cuando se abre este fichero aparece un cuadro de diálogo en el que se pregunta qué acción se quiere realizar. Con pulsar sobre “execute” o sobre “execute in terminal” se ejecuta y se abre la interfaz gráfica.

Figura 42: Opciones al abrir perfusion_19.py

El código perfusión_19.py contiene las acciones descritas en los códigos de cada módulo del subapartado 3.1.5 junto a nuevas líneas de código para algunas acciones específicas de este proyecto. En este subapartado se explicarán las líneas de código más relevantes, aunque si se desea ver el código completo, se puede encontrar en el apartado ANEXO:

- Se importan desde PyQt5 ciertas librerías para la codificación de la interfaz gráfica:

from PyQt5 import uic, QtWidgets, QtGui, QtCore

from PyQt5.QtGui import QPixmap

from PyQt5.QtGui import QFont

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

from PyQt5.QtWidgets import QApplication, QFileDialog

- Se le asigna a una variable el nombre del archivo en el que se creó la interfaz gráfica con Qt Designer

qtCreatorFile = "interfaz_05.ui"

- Se crea la interfaz cargando el archivo .ui generado en Qt Designer.

Ui_MainWindow, QtBaseClass = uic.loadUiType(qtCreatorFile)

- Se crea una clase llamada “MyApp” que hereda de las bibliotecas de Qt e inicializa las clases principales. Esta parte siempre debe aparecer en cualquier código de Python en el que se quiera realizar una interfaz gráfica con Qt.

class MyApp(QtWidgets.QMainWindow, Ui_MainWindow):

def __init__(self):

QtWidgets.QMainWindow.__init__(self)

Ui_MainWindow.__init__(self)

self.closeEvent = self.closeEvent

self.setupUi(self)

- Se añaden botones los cuales vinculan botones creados en la interfaz grafica (.ui) con funciones en el código perfusión_19.py. Nota: Se ponen algunos ejemplos no todas las vinculaciones de todos los botones.

self.btn_relay1_on.clicked.connect(self.buttonPress_relay1_on)

self.btn_pump_9.clicked.connect(self.getit_thermo1)

self.pushButton_buzzer.clicked.connect(self.buttonPress_buzzer)

self.btn_pump2.clicked.connect(self.buttonPress_pump2)

- Se definen las diferentes funciones que se ejecutan cuando se pulsa los botones correspondientes. Un ejemplo de cada módulo sería:
- Relé: Encendido del relé 1.

def buttonPress_relay1_on(self):

GPIO.setup(pin_relay1, GPIO.OUT)

GPIO.output(pin_relay1, False)

- Termopar: lectura del termopar 1 y visualización sobre el display.

def getit_thermo1(self):

temp_1 = sensor_1.read_temp_c()

internal_1 = sensor_1.read_internal_temp_c()

self.lineEdit_34.setText(format(temp_1))

- Buzzer: ejecución de la melodía del buzzer

def buttonPress_buzzer(self):

buzzer = Buzzer()

buzzer.play(3)

- MCP4725: Se escribe un valor digital en la casilla (lineEdit_pump2) y al pulsar el botón (byn_pump2) dicho valor se convierte a voltaje analógico en el MCP4725.

def buttonPress_pump2(self):

self.writeVoltage_b(int(self.lineEdit_pump2.text()))

def writeVoltage_b(self, voltage):

Interfaz gráfica

try:

dac_b.raw_value = int(voltage)

print("well")

print(voltage)

except:

print("Error with I2C module")

print(int(voltage))

- Se importa el código Plotter.py a la ventana (CustomWidget) creada en la pestaña Overview. En él se ha programado la lectura en tiempo real de cada termopar y se ha representado sobre una gráfica. Su explicación se detalla tras acabar con la descripción del código perfusión_19.py.

from Plotter import CustomWidget

- El código principal crea una nueva aplicación de interfaz gráfica en la que se hace una llamada a la clase creada y se muestra.

if __name__ == "__main__":

app = QtWidgets.QApplication(sys.argv)

#We call 'MyApp' class

window = MyApp()

#Show the generated form

window.show()

sys.exit(app.exec_())

Para visualizar la monitorización de las temperaturas de los termopares se ha elaborado un código denominado Plotter.py, el cual se ha importado sobre el programa perfusión_19.py por lo que no hace falta ejecutarlo de forma individual. A continuaciónse explicarán las líneas de código más relevantes, aunque si se desea ver el código completo, se puede encontrar en el apartado ANEXO:

- Se importan las librerías pyqtgraph para elaborar representaciones gráficas, y numpy para el procesamiento de gran cantidad de datos.

from numpy import *

from pyqtgraph.Qt import QtGui, QtCore

- Se crea la clase “CustomWidget” donde se visualizará la gráfica. Se configura el fondo de la gráfica de color negro y se inicializa el tiempo en 0

class CustomWidget(pg.GraphicsWindow):

pg.setConfigOption('foreground', 'w')

ptr1 = 0

- Dentro de esta clase se configuran aspectos como título de la gráfica, títulos de los ejes, inicialización de 3 matrices donde se guardarán las lecturas de los termopares (self.data), legenda de la gráfica y velocidad de lectura.

def __init__(self, parent=None, **kargs):

| pg.GraphicsWindow.__init__(self, **kargs)
| self.setParent(parent)

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

self.setWindowTitle('pyqtgraph example: Scrolling Plots')

p1 | = | self.addPlot(labels | = | {'left':'Temperatura | (ºC)',
'bottom':'Tiempo (s'})

self.data1 = np.random.normal(size=100)

self.data2 = np.random.normal(size=100)

self.data3 = np.random.normal(size=100)

self.curve1 = p1.plot(self.data1, pen='y', name="termpopar 1")

self.curve2 = p1.plot(self.data2, pen='m', name="termpopar 2")

self.curve3 = p1.plot(self.data3, pen='c', name="termpopar 3")

timer = pg.QtCore.QTimer(self)

timer.timeout.connect(self.update)

timer.start(100) # number of seconds for next update

- Tras la configuración se crea una función en la que los datos de la lectura se actualizan junto al tiempo (ptr) y los antiguos se van desplazando hacia la izquierda. Esta parte se repite para cada uno de los tres termopares

def update(self):

self.data1[:-1] = self.data1[1:] # shift data in the array one sample left

temp_1 = sensor_1.read_temp_c()

self.data1[-1] = float(temp_1)

self.ptr1 += 1

self.curve1.setData(self.data1)

self.curve1.setPos(self.ptr1, 0)

- El código principal crea una gráfica en la que se hace una llamada a la clase creada y se muestra.

if __name__ == '__main__':

w = CustomWidget()

w.show()

QtGui.QApplication.instance().exec_()

Conclusiones y líneas futuras

# 5 CONCLUSIONES Y LÍNEAS FUTURAS

## 5.1 Conclusiones

Tras haber realizado este proyecto se ha comprobado que una interfaz gráfica facilita y mejora el trabajo de experimentación con el proceso de criopreservación. El usuario realiza las pruebas pertinentes en un menor tiempo y de manera más cómoda ya que la interfaz hace la experimentación más dinámica entre el usuario y el software. Así, cualquier persona que trabaje en el laboratorio no requiere de conocimientos previos sobre informática y electrónica para poder configurar y utilizar las bombas.

Por otro lado, durante la elaboración se ha encontrado numerosos inconvenientes que han costado resolver y han ralentizado los plazos de ejecución.

En primer lugar, los módulos no estaban soldados por lo que se tuvo que aprender durante varios días cómo soldar dispositivos electrónicos. Seguido, la puesta en marcha de cada uno de estos módulos para comprobar su correcto funcionamiento y descartar que estuvieran defectuosos no fue tarea sencilla. Python es un lenguaje de programación relativamente sencillo, pero como nunca antes se ha había trabajado con él, costó tiempo acomodarse a utilizar su estructura, funciones y variables. Además, ciertos módulos tienen protocolos de comunicación específicos que se tuvieron que habilitar en la configuración de la Raspberry y librerías que tuvieron que ser importadas en los códigos para poderlos programar conforme a funciones específicas y que actuaran según las especificaciones que debía cumplir la interfaz gráfica como por ejemplo la lectura de los termopares o el envío de la señal analógica a las bombas a través del MCP4725.

Una vez comprobado que todos los módulos funcionaban correctamente, se pasó a diseñar una placa PCB. De nuevo, nunca antes se había trabajado con el programa EAGLE y se invirtió mucho en aprender a diseñar el esquema de cada módulo, sus huellas, teniendo en cuenta sus medidas y la distancia entre pines de cada uno, y el ruteado para que ninguna pista se cruzara con otra y provocase un cortocircuito.

Todas estas precauciones había que tenerlas presentes ya que más tarde había que imprimir la PCB y construirla con las medidas reales de cada módulo.

Llegados hasta este punto, ahora sí se podía empezar a crear la interfaz gráfica. Los mayores problemas en esta parte se centraron en vincular cada Widget (conjunto de botones, cuadro de textos, ventanas y cuadros combinados que forman la interfaz gráfica) a la función de Python que hacia actuar a cada módulo. Existe información y tutoriales sobre cómo crear una interfaz gráfica utilizando PyQt5 y Qt Creator, pero la gran mayoría son ejemplos muy sencillos que no se aproximan a la dificultad de este proyecto. Debido a esto para algunas acciones de la interfaz gráfica se consiguieron a base de pruebas, recopilando información de la web oficial de Qt¹⁵

La realización de la monitorización, es decir, la lectura de cada uno de los tres termopares y la posterior representación sobre una gráfica en tiempo real fue el mayor de los problemas. En un principio se pensó que mediante Qt Creator existía algún método para representar lo que los tres termopares recopilaban sobre una misma gráfica. Resultó no ser así. La solución pasaba por crear una ventana en Qt Creator denominada “CustomWidget” sobre la que se importaría un código aparte programado en Python que realizara la lectura y la representación en tiempo real (Plotter.py). Para la realización de dicho código se consideraron diferentes alternativas:

- Matplotlib
- Pyqtgraph

De las dos opciones se decantó por Pyqygraph ya que tiene un mejor funcionamiento cuando se trata gran cantidad de datos que se quieren representar.

15 https://www.qt.io/

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

Para finalizar hay mucho trabajo por delante para mejorar la información sobre la creación de interfaces gráficas con software gratuito mediante los medios utilizados en este proyecto, pero aun así se ha logrado crear una interfaz gráfica funcional que cumpla con los requisitos especificados. Junto a esta memoria se adjunta unos vídeos en los que se puede visualizar el correcto funcionamiento de la interfaz gráfica.

## 5.2 Líneas futuras

La finalidad de este trabajo fin de grado es actualizar un sistema obsoleto que hace uso de unas aplicaciones en desuso y tras él el proyecto es escalable y abierto a posibles mejoras, es decir cualquier persona que lo desee puede actuar sobre el sistema implementado y modificar el comportamiento del proyecto con pocos conocimientos.

Una de las posibles mejoras sería el ajuste automático de la función de transferencia que caracteriza el sistema con la incorporación del caudalímetro que se puede observar en la imagen, para saber cuánto líquido circula por los tubos. Con él se podría implementar un sistema de control PID para corregir las desviaciones en tiempo real que se producen con la cantidad de líquido que atraviesa los tubos y autoajustar la función de transferencia del sistema.


Figura 43: Medidor de flujo de líquido (caudalímetro). También existen unas zonas muertas en las que las bombas no funcionan ya que dependen del rozamiento que produce la carga con la que se esté trabajando. Con la implementación de un control PID se podría resolver ya que se sube el voltaje hasta que las bombas logran arrancar y empieza a medirse fluido.

Por último, la mejora más llamativa y que no se ha podido llevar a cabo por falta de tiempo sería la ampliación de la interfaz gráfica con una nueva pestaña llamada “Protocols” en la que el usuario podría elegir qué experimento de concentraciones se quiere llevar a cabo: experimento en meseta o experimento en rampa.

Anexos

# ANEXOS

## ANEXO A: CÓDIGOS

## Código: test_general.py

#!/usr/bin/env python3

import RPi.GPIO as GPIO
# Global Imports

import logging | #para los termopares
import time | #para el tiempo
import Adafruit_GPIO | #para los termopares
import board | #para los MCP4725
import busio | #para los MCP4725
import adafruit_mcp4725 | #para los MCP4725

# Local Imports

from Adafruit_MAX31856 import MAX31856 as MAX31856 #para los termopares

########Para los termopares##################### solo cambiar la configuracion

###solo cambiar la configuracion "cs" en el caso de que se quieran utilizar otros pines

logging.basicConfig(
filename='simpletest.log',
level=logging.DEBUG,
format='%(asctime)s - %(name)s - %(levelname)s - %(message)s') _logger = logging.getLogger(__name__)

# Uncomment one of the blocks of code below to configure your Pi to use software or hardware SPI.

## Raspberry Pi software SPI configuration.

software_spi_1 = {"clk": 11, "cs": 7, "do": 9, "di": 10} sensor_1 = MAX31856(software_spi=software_spi_1, tc_type=MAX31856.MAX31856_K_TYPE)

software_spi_2 = {"clk": 11, "cs": 8, "do": 9, "di": 10} sensor_2 = MAX31856(software_spi=software_spi_2, tc_type=MAX31856.MAX31856_K_TYPE)

software_spi_3 = {"clk": 11, "cs": 12, "do": 9, "di": 10} sensor_3 = MAX31856(software_spi=software_spi_3, tc_type=MAX31856.MAX31856_K_TYPE)

# Raspberry Pi hardware SPI configuration.

#SPI_PORT = 0

#SPI_DEVICE = 0

#sensor = MAX31856(hardware_spi=Adafruit_GPIO.SPI.SpiDev(SPI_PORT, SPI_DEVICE), tc_type=MAX31856.MAX31856_K_TYPE)

############Para los MCP4725###########################

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

# Initialize I2C bus.

i2c = busio.I2C(board.SCL, board.SDA)

# Initialize MCP4725_a.

dac_a = adafruit_mcp4725.MCP4725(i2c, address=0x60)
# Optionally you can specify a different addres if you override the A0 pin. #amp = adafruit_max9744.MAX9744(i2c, address=0x60)

# There are a three ways to set the DAC output, you can use any of these:

dac_a.value = 65500 | # Use the value property with a 16-bit number just like
# the AnalogOut class. | Note the MCP4725 is only a 12-bit

# DAC so quantization errors will occur. | The range of

# values is 0 (minimum/ground) to 65535 (maximum/Vout).

dac_a.raw_value = 4095 # Use the raw_value property to directly read and write
# the 12-bit DAC value. The range of values is # 0 (minimum/ground) to 4095 (maximum/Vout).

dac_a.normalized_value = 1.0 # Use the normalized_value property to set the # output with a floating point value in the range # 0 to 1.0 where 0 is minimum/ground and 1.0 is # maximum/Vout.

# Initialize MCP4725_b.

dac_b = adafruit_mcp4725.MCP4725(i2c, address=0x61)
# Optionally you can specify a different addres if you override the A0 pin. #amp = adafruit_max9744.MAX9744(i2c, address=0x60)

# There are a three ways to set the DAC output, you can use any of these:

dac_b.value = 65500 | # Use the value property with a 16-bit number just like
# the AnalogOut class. | Note the MCP4725 is only a 12-bit

# DAC so quantization errors will occur. | The range of

# values is 0 (minimum/ground) to 65535 (maximum/Vout).

dac_b.raw_value = 4095 # Use the raw_value property to directly read and write
# the 12-bit DAC value. The range of values is # 0 (minimum/ground) to 4095 (maximum/Vout).

dac_b.normalized_value = 1.0 # Use the normalized_value property to set the # output with a floating point value in the range # 0 to 1.0 where 0 is minimum/ground and 1.0 is # maximum/Vout.

## Establecemos el sistema de numeracion que queramos, en mi caso BCM GPIO.setmode(GPIO.BCM)

## Definimos pines a usar

RelayPin_1 = 27
RelayPin_2 = 22

led_pins = [5,6,13]

## Configurar GPIOS como salidas GPIO.setup(RelayPin_1, GPIO.OUT)

Anexos

GPIO.setup(RelayPin_2, GPIO.OUT)

for x in led_pins:
GPIO.setup(x, GPIO.OUT)
GPIO.output(x, GPIO.LOW)
#### | DEFINICION DE CLASES COMO OBJETOS | #########

#################################################################### class Buzzer(object):

def __init__(self):
GPIO.setmode(GPIO.BCM)
self.buzzer_pin = 18 #set to GPIO pin 18 GPIO.setup(self.buzzer_pin, GPIO.IN) GPIO.setup(self.buzzer_pin, GPIO.OUT) print("buzzer ready")

def __del__(self):
class_name = self.__class__.__name__
print (class_name, "finished")

def buzz(self,pitch, duration): #create the function “buzz” and feed it the pitch and duration)

if(pitch==0):
time.sleep(duration)
return
period = 1.0 / pitch | #in physics, the period (sec/cyc) is the inverse
of the frequency (cyc/sec)
delay = period / 2 | #calcuate the time for half of the wave
cycles = int(duration * pitch) | #the number of waves to produce is the
duration times the frequency
for i in range(cycles): | #start a loop from 0 to the variable “cycles”
calculated above
GPIO.output(self.buzzer_pin, True) | #set pin 18 to high
time.sleep(delay) | #wait with pin 18 high
GPIO.output(self.buzzer_pin, False) | #set pin 18 to low
time.sleep(delay) | #wait with pin 18 low

def play(self, tune):
GPIO.setmode(GPIO.BCM)
GPIO.setup(self.buzzer_pin, GPIO.OUT) x=0

print("Playing tune ",tune)
if(tune==1):
pitches=[262,294,330,349,392,440,494,523, 587, 659,698,784,880,988,1047]
| duration=0.1 for p in pitches:
self.buzz(p, duration) | #feed the pitch and duration to the function,
“buzz”
| time.sleep(duration *0.5) for p in reversed(pitches): self.buzz(p, duration) time.sleep(duration *0.5)

elif(tune==2):
| pitches=[262,330,392,523,1047] duration=[0.2,0.2,0.2,0.2,0.2,0,5]

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

for p in pitches:
self.buzz(p, duration[x]) #feed the pitch and duration to the function, “buzz”
time.sleep(duration[x] *0.5)
x+=1
elif(tune==3):
pitches=[392,294,0,392,294,0,392,0,392,392,392,0,1047,262] duration=[0.2,0.2,0.2,0.2,0.2,0.2,0.1,0.1,0.1,0.1,0.1,0.1,0.8,0.4] for p in pitches:
self.buzz(p, duration[x]) #feed the pitch and duration to the func$ time.sleep(duration[x] *0.5)
x+=1

elif(tune==4):
pitches=[1047, 988,659]
duration=[0.1,0.1,0.2]
for p in pitches:
self.buzz(p, duration[x]) #feed the pitch and duration to the func$ time.sleep(duration[x] *0.5)
x+=1

elif(tune==5):
pitches=[1047, 988,523]
duration=[0.1,0.1,0.2]
for p in pitches:
self.buzz(p, duration[x]) #feed the pitch and duration to the func$ time.sleep(duration[x] *0.5)
x+=1

GPIO.setup(self.buzzer_pin, GPIO.IN)

############### | INICIO DEL PROGRAMA | #######

if __name__ == "__main__":

try:

#Reproducirá infinatemente el test de los dispositivos while True:

##################################################### #Testeando relés (USa logica inversa)

#por lo que cuando el voltaje que se manda es 0

#el modulo se activa y si se mandan 5v se desactiva ###################################################### print ("Encendiendo Rele 1...")

GPIO.output(RelayPin_1, False) ## Enciendo el RelayPin_1 time.sleep(3) ## Esperamos 3 segundos
print ("Apagando Rele 1...")
GPIO.output(RelayPin_1, True) ## Apago el RelayPin_1

time.sleep(2) ## Esperamos 2 segundos

print ("Encendiendo Rele 2...")
GPIO.output(RelayPin_2, False) ## Enciendo el RelayPin_2 time.sleep(3) ## Esperamos 3 segundos
print ("Apagando Rele 2...")
GPIO.output(RelayPin_2, True) ## Apago el RelayPin_2

#Esperamos 2 segundos y pasamos al siguiente test

Anexos

time.sleep(2) ## Esperamos 2 segundos

##################################################### #Testeando LEDS

###################################################### # Turn on this GPIO then off

for x in led_pins:
print ("Encendiendo led del pin %s" % (str(x)) ) GPIO.output(x, GPIO.HIGH)
time.sleep(1)
print ("Apagando led del pin %s" % (str(x)) ) GPIO.output(x, GPIO.LOW)
time.sleep(1)

#Esperamos 2 segundos y pasamso al siguiente test # No LED GPIOS now (Estamos fuera del bucle) time.sleep(2) ## Esperamos 2 segundos

#################################################### # Test dle buzzer

###################################################### #Inicializamos el objeto de la clase Buzzer()

buzzer = Buzzer()
#Llamasmo a la funcion PLay de la clase Buzzer diciendole #que queremso reproducir la melodia 3 de las 5 que nos deja print ("Reproduciendo melodia")

buzzer.play(3)
print ("Melodia finalizada")

#Esperamos 2 segundos y pasamso al siguiente test # No LED GPIOS now (Estamos fuera del bucle) time.sleep(2) ## Esperamos 2 segundos

# Test de los termopares

# lectura de cada termopar 4 veces cada segundo. Se utilizan 4 buvcles for

for i in range(4):
temp = sensor_1.read_temp_c()
internal = sensor_1.read_internal_temp_c()
print('Thermocouple Temperature_1: {0:0.3F}*C'.format(temp))
print(' | Internal Temperature_1: {0:0.3F}*C'.format(internal))
print ("\n") #New line spacing
time.sleep(1.0) #Sleep the main thread 1 s

for j in range(4):
temp = sensor_2.read_temp_c()
internal = sensor_2.read_internal_temp_c()
print('Thermocouple Temperature_2: {0:0.3F}*C'.format(temp))
print(' | Internal Temperature_2: {0:0.3F}*C'.format(internal))
print ("\n") #New line spacing
time.sleep(1.0) #Sleep the main thread 1 s

for k in range(4):
temp = sensor_3.read_temp_c()

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

internal = sensor_3.read_internal_temp_c()
print('Thermocouple Temperature_3: {0:0.3F}*C'.format(temp))
print(' | Internal Temperature_3: {0:0.3F}*C'.format(internal))
print ("\n") #New line spacing
time.sleep(1.0) #Sleep the main thread 1 s
# Test de los MCP4725. Conectar las bombas a las bornas de la placa ######################################################

#MPP4725_a

# Go up the 12-bit raw range. print(' MCP4725_a Going up 0-3.3V...') for i in range(4095):

dac_a.raw_value = i
time.sleep(2.0) #Sleep the main thread 2 s # Go back down the 12-bit raw range. print(' MCP4725_a Going down 3.3-0V...') for i in range(4095, -1, -1): dac_a.raw_value = i
time.sleep(3.0) #Sleep the main thread 3 s

#MCP4725_b

# Go up the 12-bit raw range. print(' MCP4725_b Going up 0-3.3V...') for i in range(4095):

dac_b.raw_value = i
time.sleep(2.0) #Sleep the main thread 2 s # Go back down the 12-bit raw range. print(' MCP4725_b Going down 3.3-0V...') for i in range(4095, -1, -1): dac_b.raw_value = i
time.sleep(3.0) #Sleep the main thread 1 s

except KeyboardInterrupt:
#Para parar el codigo basta con hacer CTRL+C print ("\nKeyboardInterrupt has been caught.") # Hago una limpieza de los GPIO

print ("GPio cleanup")
GPIO.cleanup()

Anexos

## Código: perfusion_19.py

#!/usr/bin/env python3

#We import the libraries

import logging
import Adafruit_GPIO
import sys
import time
import inspect, os
import board
import busio
import RPi.GPIO as GPIO
import adafruit_mcp4725
from PyQt5 import uic, QtWidgets, QtGui, QtCore
from PyQt5.QtGui import QPixmap
from PyQt5.QtGui import QFont
from PyQt5.QtWidgets import QApplication, QFileDialog

from Adafruit_MAX31856 import MAX31856 as MAX31856

#Define Default Pinout

#It'll be loaded by default

pin_led1 = 23
pin_led2 = 17
pin_led3 = 3

pin_relay1 = 27
pin_relay2 = 22 #alberto

pin_buzzer = 18

pin_i2c_sda = 7
pin_i2c_scl = 8

pin_spi0_mosi = 9
pin_spi0_miso = 10
pin_spi0_sclk = 11
pin_spi0_cs0 | = 12
pin_spi0_cs1 | = 13
pin_spi0_cs2 | = 14

i2c_pump1_addr = '0x00'
i2c_pump2_addr = '0x00'
i2c_pump3_addr = '0x00'

thermo1_type = 'Type K'
thermo2_type = 'Type K'
thermo3_type = 'Type K'

#Define the lang strings

appTitle = 'Perfusion Control Panel'

#Define the system variables appWidth = 800

appHeight = 500

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

#Define the GUI and init libraries qtCreatorFile = "interfaz_05.ui"

#We create the GUI using .UI Qt designer file Ui_MainWindow, QtBaseClass = uic.loadUiType(qtCreatorFile)

#Define GPIO board mode

GPIO.setmode(GPIO.BCM)

# Initialize I2C bus.

i2c = busio.I2C(board.SCL, board.SDA)

# Initialize MCP4725.

dac_a = adafruit_mcp4725.MCP4725(i2c, address=0x60)
dac_b = adafruit_mcp4725.MCP4725(i2c, address=0x61)

# Optionally you can specify a different addres if you override the A0 pin. #amp = adafruit_max9744.MAX9744(i2c, address=0x60)

# There are a three ways to set the DAC output, you can use any of these:

dac_a.value = 65500 | # Use the value property with a 16-bit number just like
# the AnalogOut class. | Note the MCP4725 is only a 12-bit

# DAC so quantization errors will occur. | The range of

# values is 0 (minimum/ground) to 65535 (maximum/Vout).

dac_a.raw_value = 4095 # Use the raw_value property to directly read and write
# the 12-bit DAC value. The range of values is # 0 (minimum/ground) to 4095 (maximum/Vout).

dac_a.normalized_value = 1.0 # Use the normalized_value property to set the # output with a floating point value in the range # 0 to 1.0 where 0 is minimum/ground and 1.0 is # maximum/Vout.

# There are a three ways to set the DAC output, you can use any of these:

dac_b.value = 65500 | # Use the value property with a 16-bit number just like
# the AnalogOut class. | Note the MCP4725 is only a 12-bit

# DAC so quantization errors will occur. | The range of

# values is 0 (minimum/ground) to 65535 (maximum/Vout).

dac_b.raw_value = 4095 # Use the raw_value property to directly read and write
# the 12-bit DAC value. The range of values is # 0 (minimum/ground) to 4095 (maximum/Vout).

dac_b.normalized_value = 1.0 # Use the normalized_value property to set the # output with a floating point value in the range # 0 to 1.0 where 0 is minimum/ground and 1.0 is # maximum/Vout.

# Use the raw_value property to directly read and write # the 12-bit DAC value. The range of values is

# 0 (minimum/ground) to 4095 (maximum/Vout). ##dac.raw_value = 4095

#alberto--------------------------------------------------logging.basicConfig(

filename='simpletest.log',

Anexos

level=logging.DEBUG,
format='%(asctime)s - %(name)s - %(levelname)s - %(message)s') _logger = logging.getLogger(__name__)

# Uncomment one of the blocks of code below to configure your Pi to use software or hardware SPI.

## Raspberry Pi software SPI configuration.

software_spi_1 = {"clk": 11, "cs": 7, "do": 9, "di": 10} sensor_1 = MAX31856(software_spi=software_spi_1, tc_type=MAX31856.MAX31856_K_TYPE)

software_spi_2 = {"clk": 11, "cs": 8, "do": 9, "di": 10} sensor_2 = MAX31856(software_spi=software_spi_2, tc_type=MAX31856.MAX31856_K_TYPE)

software_spi_3 = {"clk": 11, "cs": 12, "do": 9, "di": 10} sensor_3 = MAX31856(software_spi=software_spi_3, tc_type=MAX31856.MAX31856_K_TYPE) #-----------------------------------------------------------

class Buzzer(object):
def __init__(self):
GPIO.setmode(GPIO.BCM)
self.buzzer_pin = 18 #set to GPIO pin 18 GPIO.setup(self.buzzer_pin, GPIO.IN) GPIO.setup(self.buzzer_pin, GPIO.OUT) print("buzzer ready")

def __del__(self):
class_name = self.__class__.__name__
print (class_name, "finished")

def buzz(self,pitch, duration): #create the function “buzz” and feed it the pitch and duration)

if(pitch==0):
time.sleep(duration)
return
period = 1.0 / pitch | #in physics, the period (sec/cyc) is the inverse
of the frequency (cyc/sec)
delay = period / 2 | #calcuate the time for half of the wave
cycles = int(duration * pitch) | #the number of waves to produce is the
duration times the frequency
for i in range(cycles): | #start a loop from 0 to the variable “cycles”
calculated above
GPIO.output(self.buzzer_pin, True) | #set pin 18 to high
time.sleep(delay) | #wait with pin 18 high
GPIO.output(self.buzzer_pin, False) | #set pin 18 to low
time.sleep(delay) | #wait with pin 18 low

def play(self, tune):
GPIO.setmode(GPIO.BCM)
GPIO.setup(self.buzzer_pin, GPIO.OUT) x=0

print("Playing tune ",tune)
if(tune==3):
pitches=[392,294,0,392,294,0,392,0,392,392,392,0,1047,262]

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

duration=[0.2,0.2,0.2,0.2,0.2,0.2,0.1,0.1,0.1,0.1,0.1,0.1,0.8,0.4] for p in pitches:
self.buzz(p, duration[x]) #feed the pitch and duration to the func$ time.sleep(duration[x] *0.5)
x+=1

GPIO.setup(self.buzzer_pin, GPIO.IN)

# | We create a class to Manage the GUI | ##

class MyApp(QtWidgets.QMainWindow, Ui_MainWindow):

#Default Function that will be executed when we

| #call the 'MyApp' class def __init__(self): QtWidgets.QMainWindow.__init__(self) Ui_MainWindow.__init__(self) self.closeEvent = self.closeEvent self.setupUi(self)

#Configure the Main Windows that it's going to be shown

self.setWindowTitle(appTitle) | #Set the main window title
self.resize(appWidth, appHeight) #Set the main window size

#Add a status bar to notify the user what we are doing self.statusBar().showMessage('This is a status bar')

| #Load default profile (Init GUI Values) self.loadDefaultProfile()

#Add button events (connect .ui element with button fcn action) self.btn_start.clicked.connect(self.buttonPress_Start) self.btn_stop.clicked.connect(self.buttonPress_Stop)

self.btn_relay1_on.clicked.connect(self.buttonPress_relay1_on) self.btn_relay1_off.clicked.connect(self.buttonPress_relay1_off) self.btn_relay2_on.clicked.connect(self.buttonPress_relay2_on) self.btn_relay2_off.clicked.connect(self.buttonPress_relay2_off)

#alberto----------------------------------------------------------------

self.btn_pump_9.clicked.connect(self.getit_thermo1) self.pushButton_28.clicked.connect(self.getit_thermo2) self.pushButton_27.clicked.connect(self.getit_thermo3)

self.pushButton_buzzer.clicked.connect(self.buttonPress_buzzer) #-----------------------------------------------------------------------

self.btn_saveProfile.clicked.connect(self.buttonPress_saveProfile) self.btn_loadProfile.clicked.connect(self.buttonPress_loadProfile) self.btn_resetProfile.clicked.connect(self.buttonPress_resetProfile)

self.btn_blink_led1.clicked.connect(self.buttonPress_blink_led1) self.btn_blink_led2.clicked.connect(self.buttonPress_blink_led2) self.btn_blink_led3.clicked.connect(self.buttonPress_blink_led3)

self.btn_pump1.clicked.connect(self.buttonPress_pump1)

Anexos

self.btn_pump2.clicked.connect(self.buttonPress_pump2) self.btn_pump3.clicked.connect(self.buttonPress_pump3)

# Load default .conf data if exists self.buttonPress_loadProfile()

#DEFINES FUNCTION ACTIONS FOR ELEMENTS (BUTTONS; ETC)#

## | 'TOOLS AND TEST' TAB (BUTTONS ACTIONS | ##

########################################################### def buttonPress_relay1_on(self):

| GPIO.setup(pin_relay1, GPIO.OUT) GPIO.output(pin_relay1, False)

def buttonPress_relay1_off(self):
| GPIO.setup(pin_relay1, GPIO.OUT) GPIO.output(pin_relay1, True)

def buttonPress_relay2_on(self): GPIO.setup(pin_relay2, GPIO.OUT) GPIO.output(pin_relay2, False)

def buttonPress_relay2_off(self): GPIO.setup(pin_relay2, GPIO.OUT) GPIO.output(pin_relay2, True)

#alberto--------------------------------------------------

def getit_thermo1(self):
temp_1 = sensor_1.read_temp_c()
internal_1 = sensor_1.read_internal_temp_c() self.lineEdit_34.setText(format(temp_1)) #self.lineEdit_34.setText('5')

def getit_thermo2(self):
temp_2 = sensor_2.read_temp_c()
internal_2 = sensor_2.read_internal_temp_c() self.lineEdit_35.setText(format(temp_2))
## | #self.lineEdit_34.setText('5')

| def getit_thermo3(self):
| temp_3 = sensor_3.read_temp_c()
| internal_3 = sensor_3.read_internal_temp_c()
| self.lineEdit_36.setText(format(temp_3))
## | #self.lineEdit_34.setText('5')

def buttonPress_buzzer(self): buzzer = Buzzer()
buzzer.play(3)

def buttonPress_blink_led1(self): GPIO.setup(pin_led1, GPIO.OUT) GPIO.output(pin_led1, True) time.sleep(1)
GPIO.output(pin_led1, False)

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

def buttonPress_blink_led2(self): GPIO.setup(pin_led2, GPIO.OUT) GPIO.output(pin_led2, False) time.sleep(1)
GPIO.output(pin_led2, True)

def buttonPress_blink_led3(self): GPIO.setup(pin_led3, GPIO.OUT) GPIO.output(pin_led3, True) time.sleep(1)
GPIO.output(pin_led3, False)

def buttonPress_pump1(self):
## | print('Hola, el valor elegido es: ' +

int(self.lineEdit_pump1.text()))
print('Hola, el valor elegido es: ' + self.lineEdit_pump1.text()) self.writeVoltage_a(self.lineEdit_pump1.text())

def buttonPress_pump2(self): self.writeVoltage_b(int(self.lineEdit_pump2.text()))

def buttonPress_pump3(self): self.writeVoltage(int(self.lineEdit_pump3.text()))

## | 'Preferences' TAB (BUTTONS ACTIONS | ##

def buttonPress_saveProfile(self):

#We save the config file with the user parameters

with open('config//' + 'profile.conf', 'w') as f: f.write('led1 = '+ self.lineEdit_led1.text()+ '\r') f.write('led2 = '+ self.lineEdit_led2.text()+ '\r') f.write('led3 = '+ self.lineEdit_led3.text()+ '\r') f.write('relay1 = '+ self.lineEdit_relay1.text()+ '\r') f.write('relay2 = '+ self.lineEdit_relay2.text()+ '\r') f.write('buzzer = '+ self.lineEdit_buzzer.text()+ '\r') f.write('i2c_sda = '+ self.lineEdit_i2c_sda.text()+ '\r') f.write('i2c_scl = '+ self.lineEdit_i2c_scl.text()+ '\r') f.write('spi0_mosi = '+ self.lineEdit_spi0_mosi.text()+ '\r') f.write('spi0_miso = '+ self.lineEdit_spi0_miso.text()+ '\r') f.write('spi0_sclk = '+ self.lineEdit_spi0_sclk.text()+ '\r') f.write('spi0_cs0 = '+ self.lineEdit_spi0_cs0.text()+ '\r') f.write('spi0_cs1 = '+ self.lineEdit_spi0_cs1.text()+ '\r') f.write('spi0_cs2 = '+ self.lineEdit_spi0_cs2.text()+ '\r') f.write('pump1 = '+ str(self.comboBox_i2c_pump1.currentText())+ '\r')
f.write('pump2 = '+ str(self.comboBox_i2c_pump2.currentText())+ '\r')
f.write('pump3 = '+ str(self.comboBox_i2c_pump3.currentText())+ '\r')
f.write('thermo1 = '+ str(self.comboBox_thermo1.currentText())+ '\r')
f.write('thermo2 = '+ str(self.comboBox_thermo2.currentText())+ '\r')
f.write('thermo3 = '+ str(self.comboBox_thermo3.currentText())+ '\r')

## We call this function to override the globalVars with the qelements

Anexos

self.guiToGlobalVar()

def buttonPress_loadProfile(self):
#Check if file exists, if exist load the default conf exists = os.path.isfile('config//' + 'profile.conf')

if exists:
# Store configuration file values

# We read the .conf file to load the saved previous data

file = open('config//' + 'profile.conf', mode = 'r', encoding = 'utf-8-sig')
lines = file.readlines()
file.close()

for line in lines:
line = line.split('=')
line = [i.strip() for i in line]
# Check line by line the header to assign the value to the global var

if(line[0] == 'led1'):
self.lineEdit_led1.setText(line[1])
if(line[0] == 'led2'):
self.lineEdit_led2.setText(line[1]) if(line[0] == 'led3'):
self.lineEdit_led3.setText(line[1]) if(line[0] == 'relay1'):
self.lineEdit_relay1.setText(line[1]) if(line[0] == 'relay2'):
self.lineEdit_relay2.setText(line[1]) #alberto-----------------------------------------------------------------------------------
if(line[0] == 'buzzer'):
self.lineEdit_buzzer.setText(line[1]) if(line[0] == 'i2c_sda'):
self.lineEdit_i2c_sda.setText(line[1]) if(line[0] == 'i2c_scl'):
self.lineEdit_i2c_scl.setText(line[1]) if(line[0] == 'spi0_mosi'): self.lineEdit_spi0_mosi.setText(line[1]) if(line[0] == 'spi0_miso'): self.lineEdit_spi0_miso.setText(line[1]) if(line[0] == 'spi0_sclk'): self.lineEdit_spi0_sclk.setText(line[1]) if(line[0] == 'spi0_cs0'): self.lineEdit_spi0_cs0.setText(line[1]) if(line[0] == 'spi0_cs1'): self.lineEdit_spi0_cs1.setText(line[1]) if(line[0] == 'spi0_cs2'): self.lineEdit_spi0_cs2.setText(line[1]) if(line[0] == 'pump1'):
index = self.comboBox_i2c_pump1.findText(line[1], QtCore.Qt.MatchFixedString) if index >= 0:
self.comboBox_i2c_pump1.setCurrentIndex(index) if(line[0] == 'pump2'):
index = self.comboBox_i2c_pump2.findText(line[1], QtCore.Qt.MatchFixedString)

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

if index >= 0:
self.comboBox_i2c_pump2.setCurrentIndex(index) if(line[0] == 'pump3'):
index = self.comboBox_i2c_pump3.findText(line[1], QtCore.Qt.MatchFixedString) if index >= 0:
self.comboBox_i2c_pump3.setCurrentIndex(index) if(line[0] == 'thermo1'):
index = self.comboBox_thermo1.findText(line[1], QtCore.Qt.MatchFixedString) if index >= 0:
self.comboBox_thermo1.setCurrentIndex(index) if(line[0] == 'thermo2'):
index = self.comboBox_thermo2.findText(line[1], QtCore.Qt.MatchFixedString) if index >= 0:
self.comboBox_thermo2.setCurrentIndex(index) if(line[0] == 'thermo3'):
index = self.comboBox_thermo3.findText(line[1], QtCore.Qt.MatchFixedString) if index >= 0:
self.comboBox_thermo3.setCurrentIndex(index)

## We call this function to override the globalVars with the qelements

self.guiToGlobalVar()

else:
# Keep presets

print('Config file does not exists')

def guiToGlobalVar(self):
#We override the global variables pin_led1 = int(self.lineEdit_led1.text()) pin_led2 = int(self.lineEdit_led2.text()) pin_led3 = int(self.lineEdit_led3.text()) pin_relay1 = int(self.lineEdit_relay1.text()) pin_relay2 = int(self.lineEdit_relay2.text()) pin_buzzer = int(self.lineEdit_buzzer.text()) pin_i2c_sda = int(self.lineEdit_i2c_sda.text()) pin_i2c_scl = int(self.lineEdit_i2c_scl.text()) pin_spi0_mosi = int(self.lineEdit_spi0_mosi.text()) pin_spi0_miso = int(self.lineEdit_spi0_miso.text()) pin_spi0_sclk = int(self.lineEdit_spi0_sclk.text()) pin_spi0_cs0 = int(self.lineEdit_spi0_cs0.text()) pin_spi0_cs1 = int(self.lineEdit_spi0_cs1.text()) pin_spi0_cs2 = int(self.lineEdit_spi0_cs2.text()) i2c_pump1_addr = str(self.comboBox_i2c_pump1.currentText()) i2c_pump2_addr = str(self.comboBox_i2c_pump2.currentText()) i2c_pump3_addr = str(self.comboBox_i2c_pump3.currentText()) thermo1_type = str(self.comboBox_thermo1.currentText()) thermo2_type = str(self.comboBox_thermo1.currentText()) thermo3_type = str(self.comboBox_thermo1.currentText())

def buttonPress_resetProfile(self): self.loadDefaultProfile()

Anexos

def buttonPress_Pump_1(self):
if self.btn_pump_1.isEnabled(): self.btn_pump_1.setText('STOP PUMP 1') #self.btn_pump_1.setEnabled(False) else:
self.btn_pump_1.setText('FORCE PUMP 1') #self.btn_pump_1.setEnabled(True)

def buttonPress_Start(self):
if self.btn_start.isEnabled(): self.btn_start.setEnabled(False) self.btn_stop.setEnabled(True) else:
self.btn_start.setEnabled(True) self.btn_true.setEnabled(False)

def buttonPress_Stop(self):
if self.btn_stop.isEnabled(): self.btn_start.setEnabled(True) self.btn_stop.setEnabled(False) else:
self.btn_start.setEnabled(False) self.btn_true.setEnabled(True)

def loadDefaultProfile(self): list_thermo_types = [
self.tr('Type K'),
self.tr('Type J'),
self.tr('Type N'),
self.tr('Type R'),
self.tr('Type S'),
self.tr('Type T'),
self.tr('Type E'),
self.tr('Type B')
]

list_i2c_addr = [
self.tr('0x00'),
self.tr('0x01'),
self.tr('0x02')
]

#First we get the current working path

directory = os.path.dirname(os.path.realpath(__file__))

#Load Main App "Icon"

self.setWindowIcon(QtGui.QIcon(directory + '//res//' + 'icon.png'))

#Load "About" tab logo

pixmap = QPixmap(directory + '//res//' + 'logo_fIII.png') self.label_about_logo.setPixmap(pixmap)

#Load ThermoCouples list

self.comboBox_thermo1.clear() self.comboBox_thermo2.clear() self.comboBox_thermo3.clear()

self.comboBox_thermo1.addItems(list_thermo_types) self.comboBox_thermo2.addItems(list_thermo_types) self.comboBox_thermo3.addItems(list_thermo_types)

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

#Load PUMP Addresses

self.comboBox_i2c_addr.clear() self.comboBox_i2c_pump1.clear() self.comboBox_i2c_pump2.clear() self.comboBox_i2c_pump3.clear()

self.comboBox_i2c_addr.addItems(list_i2c_addr) self.comboBox_i2c_pump1.addItems(list_i2c_addr) self.comboBox_i2c_pump2.addItems(list_i2c_addr) self.comboBox_i2c_pump3.addItems(list_i2c_addr)

#Load default pinout values

#WE must convert pin integer type to strings self.lineEdit_led1.setText(str(pin_led1)) self.lineEdit_led2.setText(str(pin_led2)) self.lineEdit_led3.setText(str(pin_led3))

self.lineEdit_relay1.setText(str(pin_relay1)) self.lineEdit_relay2.setText(str(pin_relay2)) self.lineEdit_buzzer.setText(str(pin_buzzer))

self.lineEdit_i2c_sda.setText(str(pin_i2c_sda)) self.lineEdit_i2c_scl.setText(str(pin_i2c_scl))

self.lineEdit_spi0_mosi.setText(str(pin_spi0_mosi)) self.lineEdit_spi0_miso.setText(str(pin_spi0_miso)) self.lineEdit_spi0_sclk.setText(str(pin_spi0_sclk)) self.lineEdit_spi0_cs0.setText(str(pin_spi0_cs0)) self.lineEdit_spi0_cs1.setText(str(pin_spi0_cs1)) self.lineEdit_spi0_cs2.setText(str(pin_spi0_cs2))

# Load the font:

QtGui.QFontDatabase.addApplicationFont(directory + '//res//' + 'Tahoma.ttf')
stylesheet = open(directory + '//res//' + 'mystylesheet.qss').read() self.setStyleSheet(stylesheet)

## DACMCP4725_a Voltage writter def writeVoltage_a(self, voltage): try:

dac_a.raw_value = int(voltage) print("well")
print(voltage)

except:
print("Error with I2C module") print(int(voltage))

## DACMCP4725_b Voltage writter def writeVoltage_b(self, voltage): try:

dac_b.raw_value = int(voltage) print("well")
print(voltage)

except:
print("Error with I2C module") print(int(voltage))

## Trigger event when we close the form

Anexos

def closeEvent(self, event): # Free up GPIOs
GPIO.cleanup()
# Default function that will be executed when | ####

# we run this program | ####

from Plotter import CustomWidget

if __name__ == "__main__":
app = QtWidgets.QApplication(sys.argv) #We call 'MyApp' class
window = MyApp()
#Show the generated form

window.show()
sys.exit(app.exec_())

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

## Código: Plotter.py

import pyqtgraph as pg
import numpy as np

# Global Imports

from numpy import *
from pyqtgraph.Qt import QtGui, QtCore

import logging
import time
import Adafruit_GPIO

# Local Imports

from Adafruit_MAX31856 import MAX31856 as MAX31856

logging.basicConfig(
filename='simpletest.log',
level=logging.DEBUG,
format='%(asctime)s - %(name)s - %(levelname)s - %(message)s') _logger = logging.getLogger(__name__)

# Uncomment one of the blocks of code below to configure your Pi to use software or hardware SPI.

## Raspberry Pi software SPI configuration.

software_spi_1 = {"clk": 11, "cs": 7, "do": 9, "di": 10} sensor_1 = MAX31856(software_spi=software_spi_1, tc_type=MAX31856.MAX31856_K_TYPE)

software_spi_2 = {"clk": 11, "cs": 8, "do": 9, "di": 10} sensor_2 = MAX31856(software_spi=software_spi_2, tc_type=MAX31856.MAX31856_K_TYPE)

software_spi_3 = {"clk": 11, "cs": 12, "do": 9, "di": 10} sensor_3 = MAX31856(software_spi=software_spi_3, tc_type=MAX31856.MAX31856_K_TYPE)

class | CustomWidget(pg.GraphicsWindow):
# | pg.setConfigOption('background', 'k')

pg.setConfigOption('foreground', 'w')
ptr1 = 0
def __init__(self, parent=None, **kargs): pg.GraphicsWindow.__init__(self, **kargs) self.setParent(parent)
self.setWindowTitle('pyqtgraph example: Scrolling Plots') p1 = self.addPlot(labels = {'left':'Temperatura (ยบC)', 'bottom':'Tiempo (cs)'})
# | self.data1 = np.random.normal(size=250)

# | self.data2 = np.random.normal(size=250)

# | self.data3 = np.random.normal(size=250)

self.data1 = np.zeros(100) self.data2 = np.zeros(100)
self.data3 = np.zeros(100)
# | p1.addLegend()

self.curve1 = p1.plot(self.data1, pen='y', name="termpopar 1") self.curve2 = p1.plot(self.data2, pen='m', name="termpopar 2") self.curve3 = p1.plot(self.data3, pen='c', name="termpopar 3")
# | p1.setRange(yRange=[20, 40])

Anexos

timer = pg.QtCore.QTimer(self) timer.timeout.connect(self.update)
timer.start(100) # number of seconds for next update

def update(self):
self.data1[:-1] = self.data1[1:] # shift data in the array one sample left
# (see also: np.roll)

temp_1 = sensor_1.read_temp_c()
self.data1[-1] = float(temp_1) self.ptr1 += 1
self.curve1.setData(self.data1)
self.curve1.setPos(self.ptr1, 0)
self.data2[:-1] = self.data2[1:] # shift data in the array one sample left
# (see also: np.roll)

temp_2 = sensor_2.read_temp_c()
self.data2[-1] = float(temp_2) self.curve2.setData(self.data2) self.curve2.setPos(self.ptr1,0)

self.data3[:-1] = self.data3[1:] # shift data in the array one sample left
# (see also: np.roll)

temp_3 = sensor_3.read_temp_c()
self.data3[-1] = float(temp_3) self.curve3.setData(self.data3) self.curve3.setPos(self.ptr1,0)

if __name__ == '__main__':
w = CustomWidget()
w.show()
QtGui.QApplication.instance().exec_()

## ANEXO B: PLANOS DE LA PCB

## Esquemático

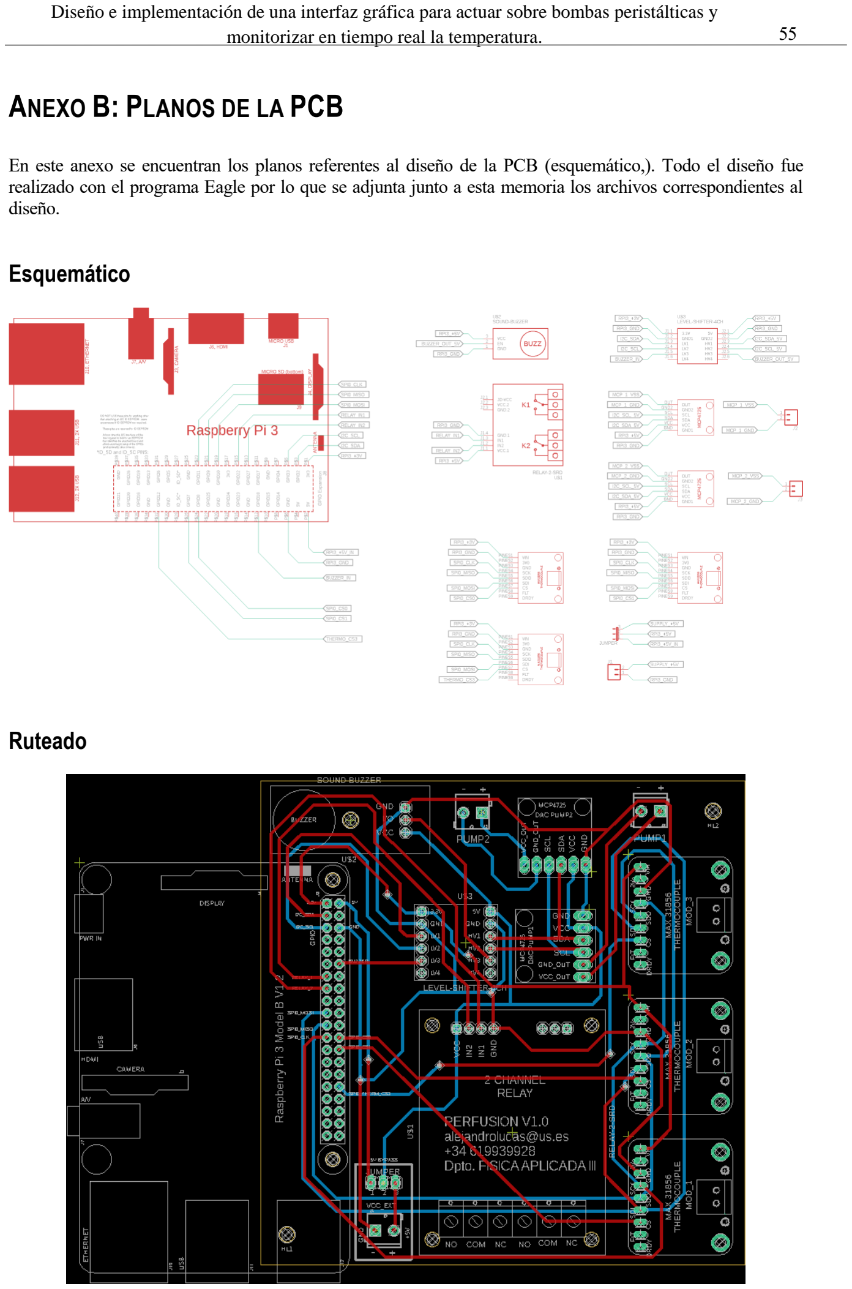
[picture p57: page 77]
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

En este anexo se encuentran los planos referentes al diseño de la PCB (esquemático,). Todo el diseño fue realizado con el programa Eagle por lo que se adjunta junto a esta memoria los archivos correspondientes al diseño.

## Ruteado

Anexos

Circuitos impresos.

Cara top

Cara bottom

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

## PCB

Cara top


Anexos

Cara bottom

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

## ANEXO C: DATASHEET

En este subapartado se puede encontrar todos los enlaces webs de los datasheet de cada uno de los dispositivos físicos utilizados en este proyecto en el caso de que se quieran consultar.

## Raspberry Pi 3 B+

https://www.raspberrypi.org/documentation/hardware/computemodule/datasheets/rpi_DATA_CM3plus_1p0. pdf (https://www.raspberrypi.org/documentation/hardware/computemodule/datasheets/rpi_DATA_CM3plus_1p0.pdf)

## MCP4725

http://ww1.microchip.com/downloads/en/DeviceDoc/22039c.pdf

## Módulo rele de 2 canales

http://www.handsontec.com/dataspecs/2Ch-relay.pdf

## Buzzer

Nota: Se deja el enlace de la compra donde viene información sobre el módulo ya que no se ha encontrado datasheet del mismo.

https://www.amazon.es/ARCELI-3-3-5V-M%C3%B3dulo-zumbador-Arduino/dp/B07MPYWVGD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 (https://www.amazon.es/ARCELI-3-3-5V-M%C3%B3dulo-zumbador-Arduino/dp/B07MPYWVGD?s=electronics)

## Termopar

https://cdn-learn.adafruit.com/assets/assets/000/035/948/original/MAX31856.pdf

## Módulo bidireccional

https://arduino-shop.eu/arduino-platform/1481-iic-i2c-5v-to-33-v-bidirectional-converter-logic-level.html

http://dlnmh9ip6v2uc.cloudfront.net/datasheets/BreakoutBoards/Logic_Level_Bidirectional.pdf

http://dlnmh9ip6v2uc.cloudfront.net/datasheets/BreakoutBoards/BSS138.pdf

# REFERENCIAS

[1] PÉREZ AGUILAR, ÁLVARO. 2018, Trabajo fin de master: Diseño e implementación de sistema de monitorización y control en temperatura y concentración de crioprotector para criopreservación de órganos.
[2] ORTIZ SERRANO ,MARÍA DEL CARMEN 2015, Trabajo fin de grado: Prototipo de sistema de perfusión de crioprotector controlada para criopreservación de órganos.
[3] MOTA MONEDERO ,IVÁN 2018, Trabajo fin de grado: Diseño e implementación

de un simulador de paciente de bajo coste basado en Raspberry Pi.

[4] MOTA MONEDERO ,IVÁN 2018, Trabajo fin de grado: Diseño e implementación

de un simulador de paciente de bajo coste basado en Raspberry Pi.

[5] Referencia de compra del módulo MCP4725. Disponible en: https://www.amazon.es/TECNOIOT-MCP4725-Breakout-Development-CJMCU-MCP4725/dp/B07KFMR87V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
[6] Referencia de compra del módulo Relé 2 canales . Disponible en: https://www.amazon.es/AZDelivery-Canales-optoacoplador-Low-Level-Trigger-Arduino/dp/B07LB2RQYP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
[7] Referencia de compra del módulo Buzzer . Disponible en: https://www.amazon.es/ARCELI-3-3-5V-M%C3%B3dulo-zumbador-Arduino/dp/B07MPYWVGD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
[8] Referencia de compra del módulo de termopar. Disponible en: https://www.amazon.es/Adafruit-universal-Thermocouple-Amplifier-max31856-Breakout/dp/B0718XZ2K7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
[9] | Referencia | de | compra | del | módulo | bidireccional. | Disponible | en:
https://www.amazon.es/XCSOURCE%C2%AE-Convertidor-Bidireccional-Unidades-TE291/dp/B0148BLZGE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
[10] Crear | copia | de | seguridad | de | la | microSD | de | la | Raspberry. | Disponible | en
https://www.redeszone.net/2018/03/23/copia-seguridad-micro-sd-raspberry-pi/
[11] Referencia de compra de la Raspberry PI 3 B+ . Disponible en: https://www.amazon.es/Raspberry-Pi-Modelo-Complete-Kit/dp/B07BR226BG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
[12] Información del programa PyQt. Disponible en: https://es.wikipedia.org/wiki/PyQt

Referencias

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
