alelucrod/Perfusion/1.Memoria/imágenes/Captura.JPG

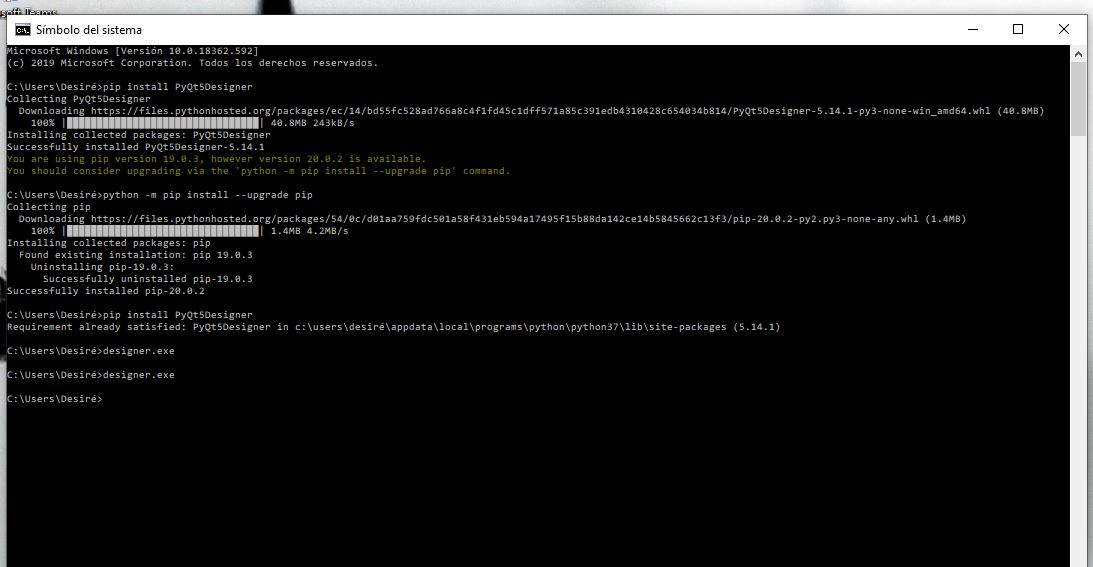
1.Memoria/imágenes/Captura.JPG
