alelucrod/Perfusion/1.Memoria/imágenes/pantalla inicial grande QtDesigner.JPG

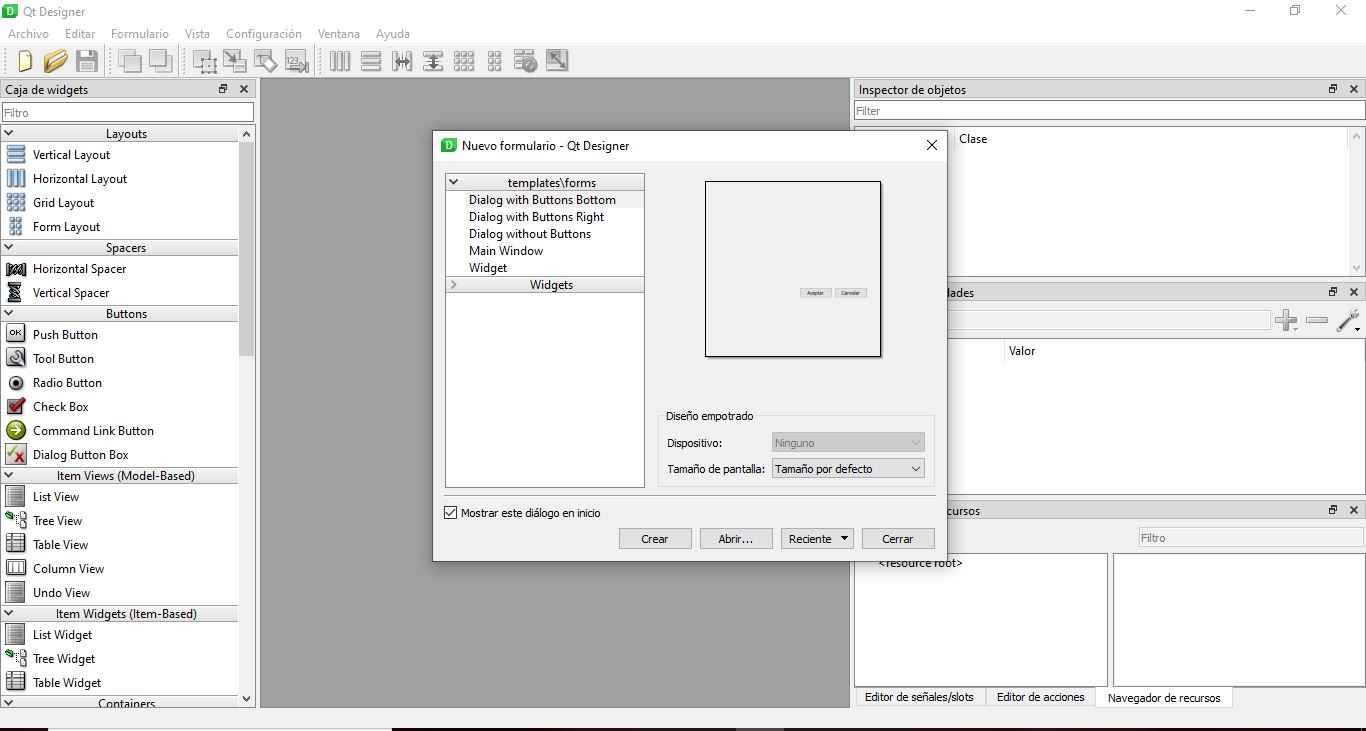
1.Memoria/imágenes/pantalla inicial grande QtDesigner.JPG
