alelucrod/Perfusion/1.Memoria/imágenes/ventana pequeña inicial QtDesigner para clicar en abrir.JPG

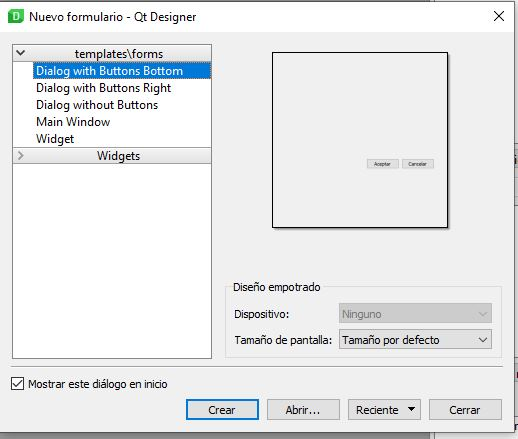
1.Memoria/imágenes/ventana pequeña inicial QtDesigner para clicar en abrir.JPG
