alelucrod/Perfusion/4.Hardware/perfusion_placa_eagle/projects/Perfusion/Imprimibles/esquematico_eagle.PNG

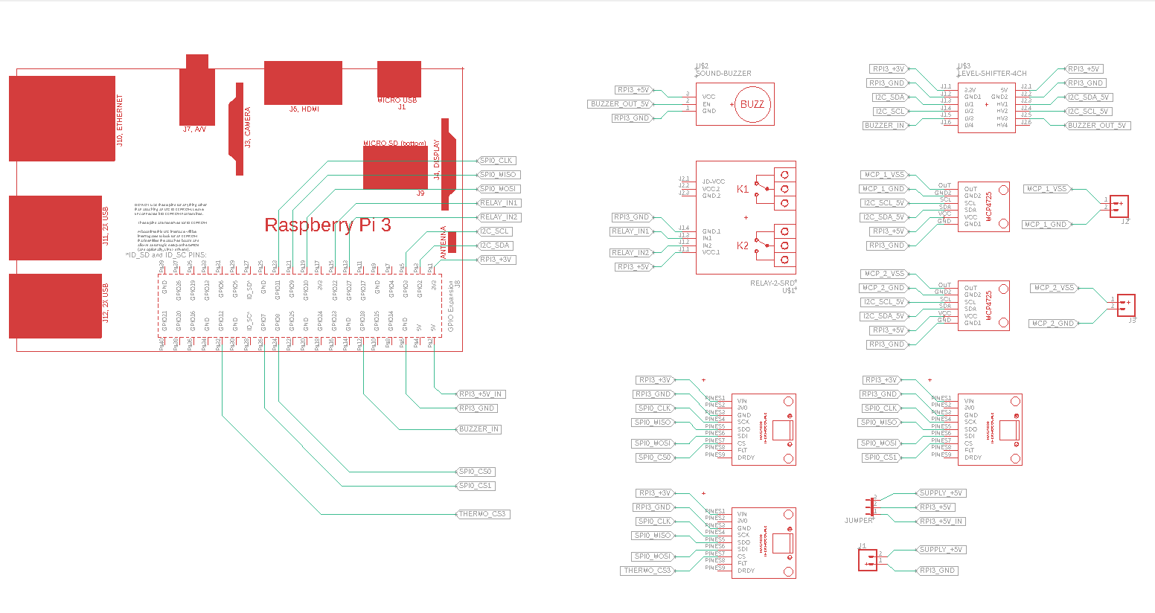
4.Hardware/perfusion_placa_eagle/projects/Perfusion/Imprimibles/esquematico_eagle.PNG
