alelucrod/Perfusion/5.Multimedia/5.5_Modelos_3D/16032020_Modelo3D_V2/ensamblajetotal.STL

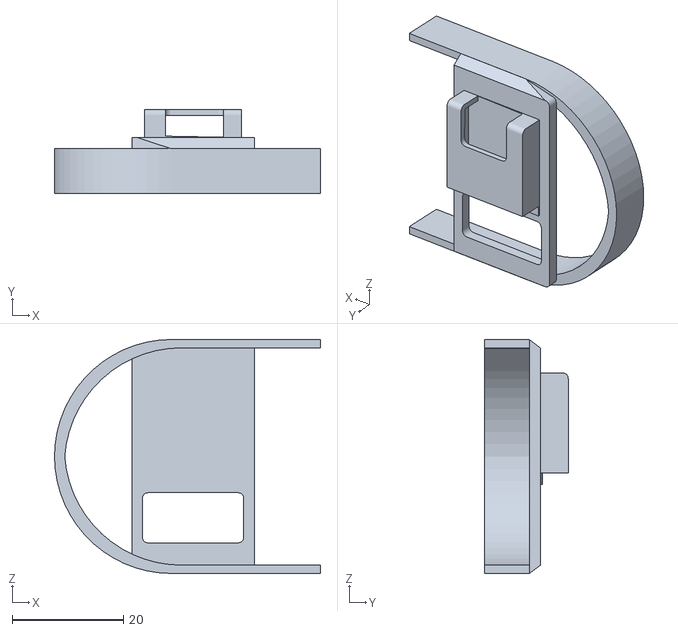
[picture p63: CAD file, 2020-03-18]
5.Multimedia/5.5_Modelos_3D/16032020_Modelo3D_V2/ensamblajetotal.STL
47.7 x 15.0 x 42.0
