alelucrod/Perfusion/5.Multimedia/5.5_Modelos_3D/16032020_Modelo3D_V2/Soporte_hall.SLDPRT

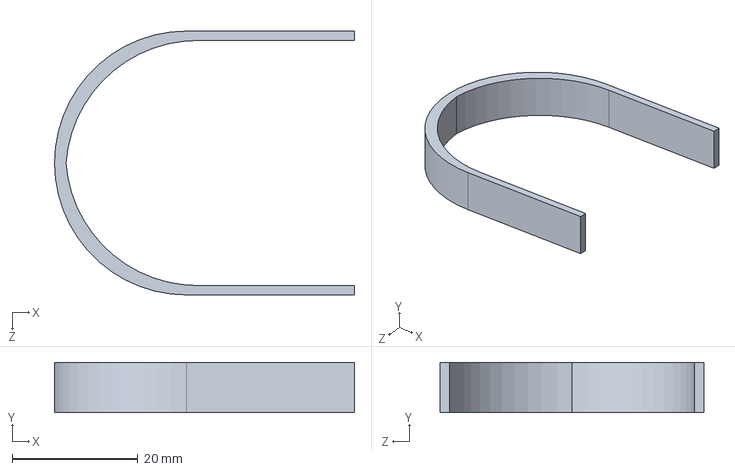
[picture p64: CAD file, 2020-03-18]
5.Multimedia/5.5_Modelos_3D/16032020_Modelo3D_V2/Soporte_hall.SLDPRT
47.7 x 8.00 x 42.0 mm
