alelucrod/Perfusion/5.Multimedia/5.5_Modelos_3D/16032020_Modelo3D_V2/Soporte_hall_acople.SLDPRT

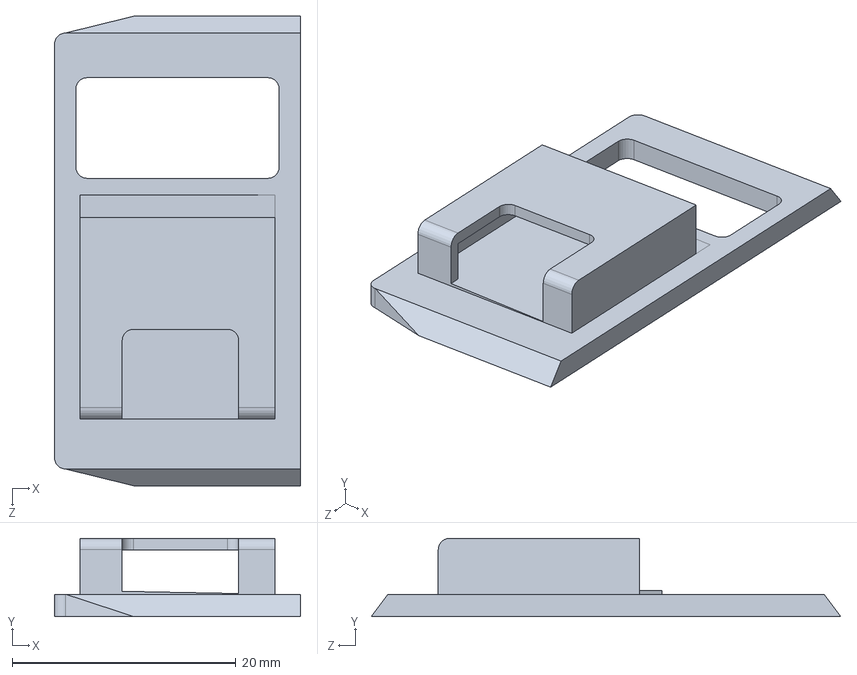
[picture p65: CAD file, 2020-03-18]
5.Multimedia/5.5_Modelos_3D/16032020_Modelo3D_V2/Soporte_hall_acople.SLDPRT
22.0 x 7.00 x 42.0 mm
