alelucrod/Perfusion/(list of files, cad)

Other CAD files:
5.Multimedia/5.5_Modelos_3D/16032020_Modelo3D_V2/Ensamblaje_Modulo_hall.SLDASM
5.Multimedia/5.5_Modelos_3D/16032020_Modelo3D_V2/Soporte_hall_modulo.SLDPRT
