alelucrod/Perfusion/5.Multimedia/5.5_Modelos_3D/16032020_Modelo3D_V2/Ensamblaje_Modulo_hall.PNG

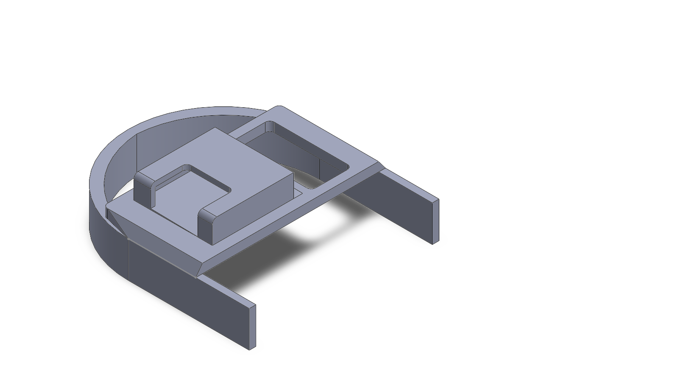
5.Multimedia/5.5_Modelos_3D/16032020_Modelo3D_V2/Ensamblaje_Modulo_hall.PNG
