alelucrod/Perfusion/4.Hardware/perfusion_placa_eagle/24032020_Esquematico.pdf

# RPI3_GND RPI3_GND

# MCP_1_VSS MCP_1_VSS

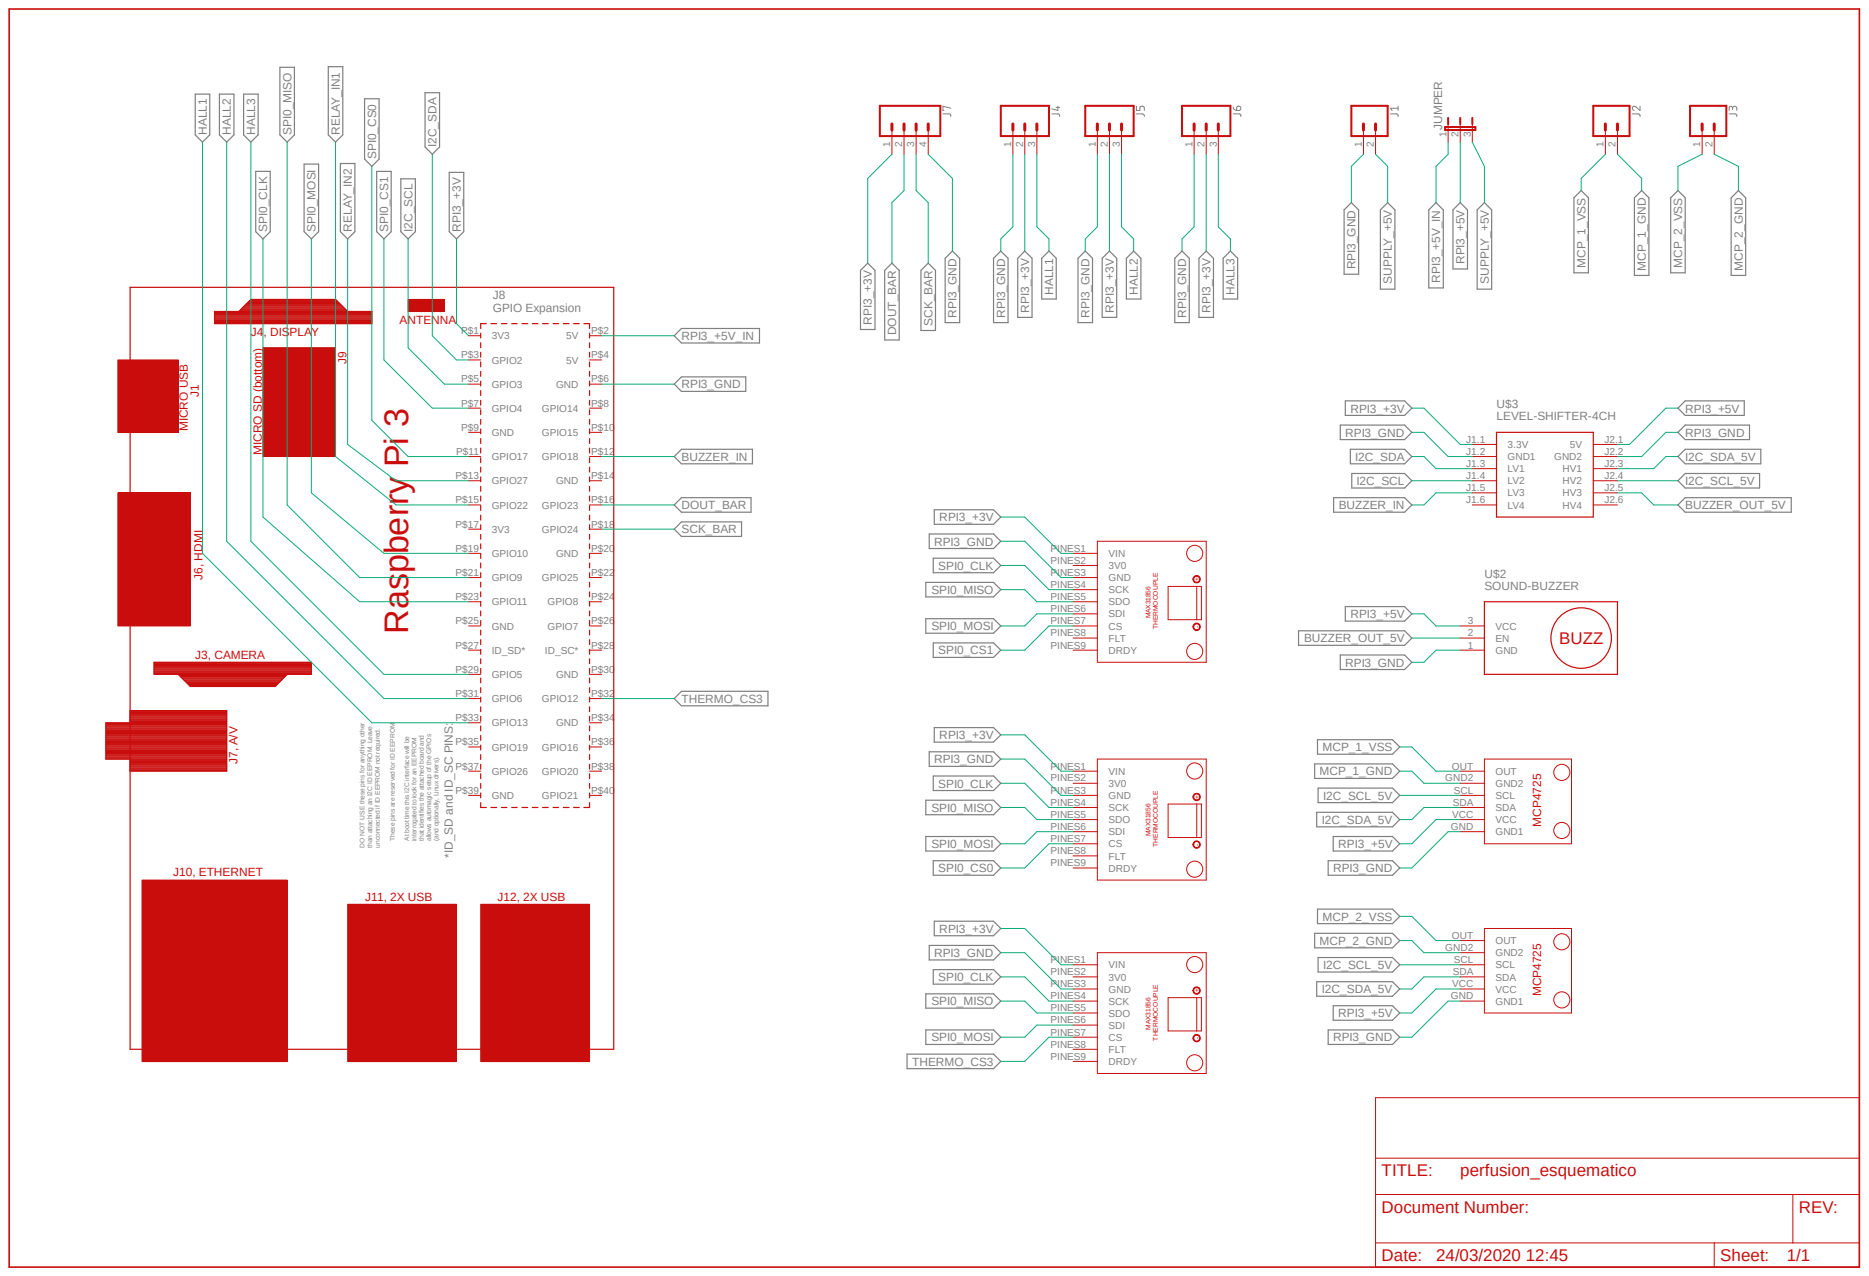
[picture p68: page 1]
SOUND-BUZZER; LEVEL-SHIFTER-4CH; 5V P$2 GPIO2 P$3; 5V P$4 GPIO3 P$5; GND P$6 GPIO4 P$7; GPIO14 P$8 GND P$9; GPIO15 P$10 GPIO17 P$11; GPIO18 P$12 GPIO27 P$13; GND P$14 GPIO22 P$15; GPIO23 P$16; GPIO24 P$18 GPIO10 P$19; GND P$20 GPIO9 P$21; GPIO25 P$22 GPIO11 P$23; GPIO8 P$24 GND P$25; GPIO7 P$26; ID_SC* P$28 GPIO5 P$29; GND P$30 GPIO6 P$31; GPIO12 P$32 GPIO13 P$33; GND P$34 GPIO19 P$35; GPIO16 P$36 GPIO26 P$37; GPIO20 P$38 GND P$39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

J4, DISPLAY MICRO SD ⁽bottom⁾ MICRO USB J6, HDMI

Document Number: | REV:

Date: 24/03/2020 12:45 | Sheet: 1/1
