alelucrod/Perfusion/4.Hardware/perfusion_placa_eagle/projects/Perfusion/Imprimibles/board.pdf

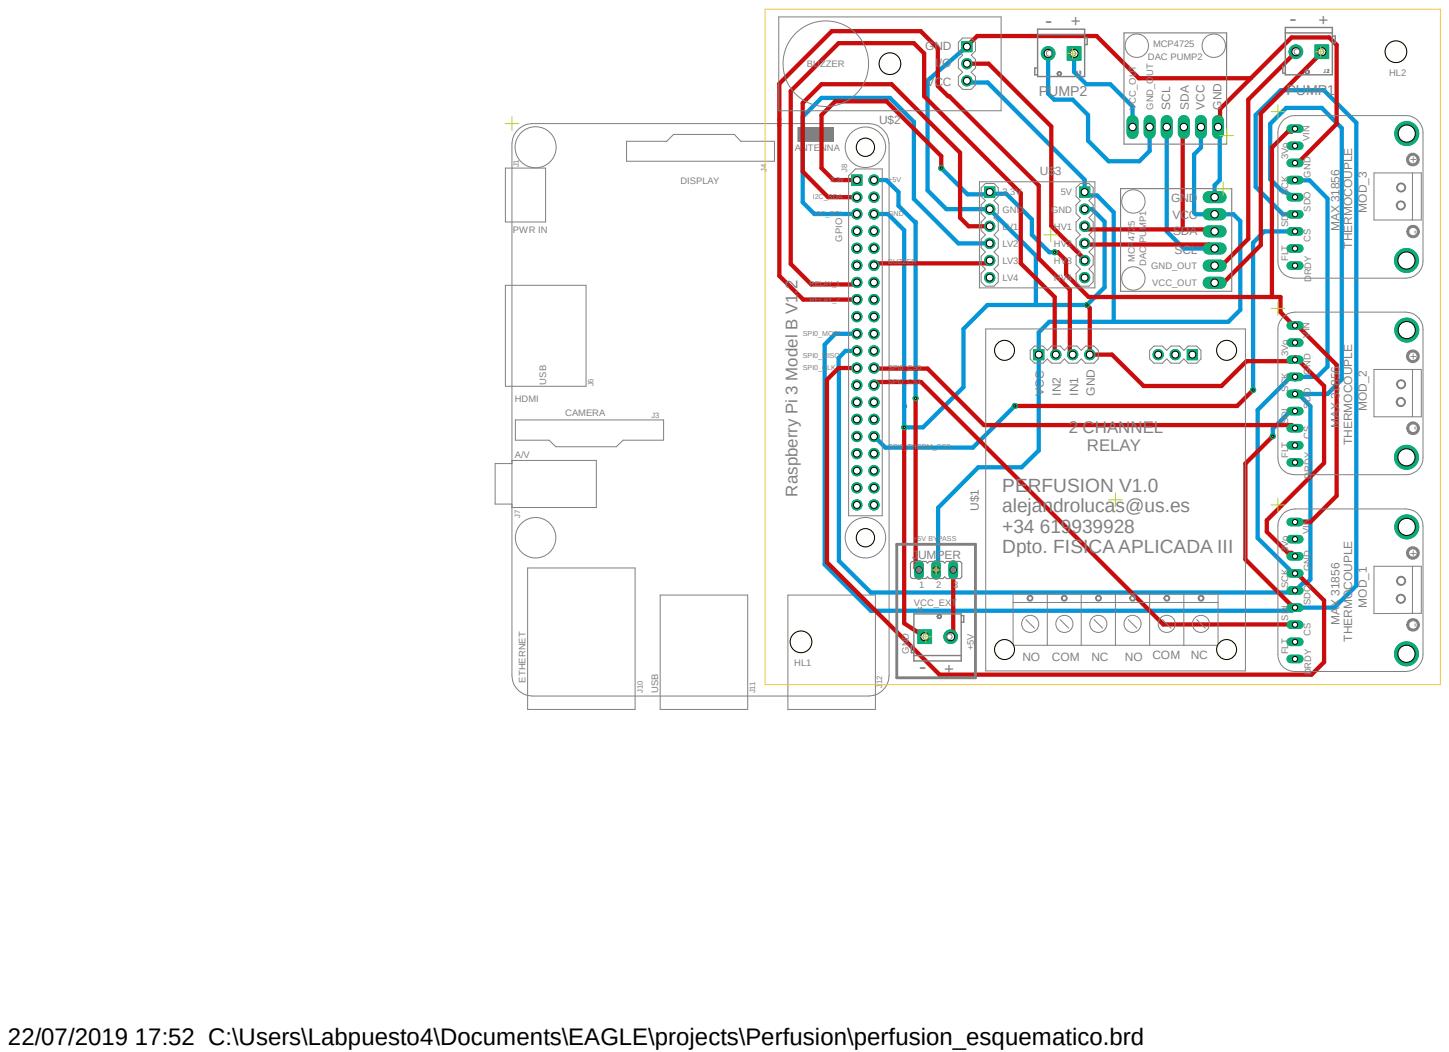
[picture p69: page 1]

GND

+ - MAX 31856 THERMOCOUPLE FLT SDO SDI SCK CS DRDY GND3Vo VIN

22/07/2019 17:52 C:\Users\Labpuesto4\Documents\EAGLE\projects\Perfusion\perfusion_esquematico.brd J6

PERFUSION V1.0
alejandrolucas@us.es
Dpto. FISICA APLICADA III
