alelucrod/Perfusion/4.Hardware/perfusion_placa_eagle/projects/Perfusion/Imprimibles/esquematico.pdf

22/07/2019 17:53 C:\Users\Labpuesto4\Documents\EAGLE\projects\Perfusion\perfusion_esquematico.sch (Sheet: 1/1) | 3V³ P$1 5V P$2 GPIO² P$3 5V P$4 GPIO³ P$5 GND P$6 GPIO⁴ P$7 GPIO¹⁴ P$8 GND P$9 GPIO¹⁵ P$10 GPIO¹⁷ P$11 GPIO¹⁸ P$12 GPIO²⁷ P$13 GND P$14 GPIO²² P$15 GPIO²³ P$16 3V³ P$17 GPIO²⁴ P$18 GPIO¹⁰ P$19 GND P$20 GPIO⁹ P$21 GPIO²⁵ P$22 GPIO¹¹ P$23 GPIO⁸ P$24 GND P$25 GPIO⁷ P$26 ID_SD* P$27 ID_SC* P$28 GPIO⁵ P$29 GND P$30 GPIO⁶ P$31 GPIO¹² P$32 GPIO¹³ P$33 GND P$34 GPIO¹⁹ P$35 GPIO¹⁶ P$36 GPIO²⁶ P$37 GPIO²⁰ P$38 GND P$39 GPIO²¹ P$40

*ID_SD and ID_SC PINS:

These pins are reserved for ID EEPROM

At boot time this I2C interface will be interrogated to look for an EEPROM that identifies the attached board and allows automagic setup of the GPIOs (and optionally, Linux drivers).

DO NOT USE these pins for anything other
than attaching an I2C ID EEPROM. Leave
unconnected if ID EEPROM not required. | J8 GPIO Expansion

RPI3_GND

BUZZER_IN

RELAY_IN1

RELAY_IN2

SPI0_MOSI

SPI0_MISO

SPI0_CLK

SPI0_CS0

SPI0_CS1

I2C_SDA

I2C_SCL

RPI3_+3V

THERMO_CS3

RPI3_+5V_IN

Raspberry Pi 3 | J4, DISPLAYMICRO SD (bottom)

MICRO USB

J6, HDMI J3, CAMERA J7, A/V J10, ETHERNET J11, 2X USB J12, 2X USB

J9

# J1 ANTENNA

## BUZZ

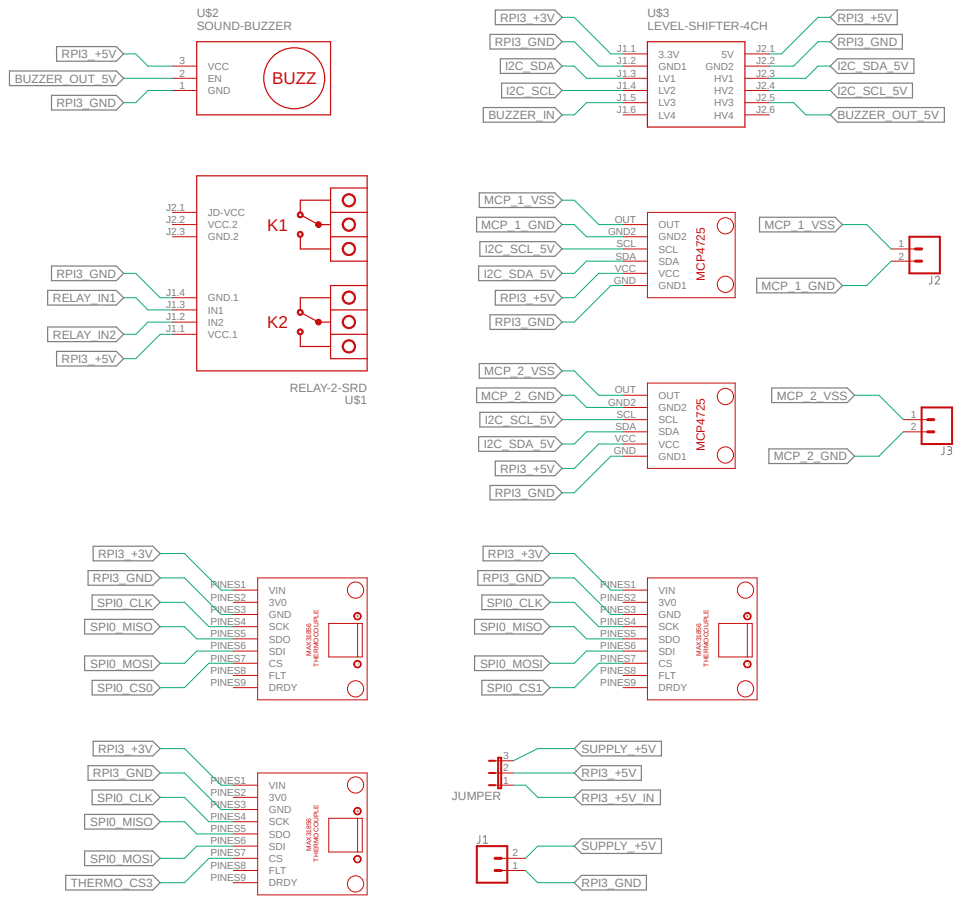
[picture p70: page 2]
SOUND-BUZZER; LEVEL-SHIFTER-4CH; VCC.1 J1.1; GND.1 J1.4; GND.2 J2.3; VCC.2 J2.2; JD-VCC J2.1; RELAY-2-SRD; VCC 3 EN 2; GND 1 U$2; GND1 J1.2; J2.3 GND2; VIN PINES1 3V0 PINES2 GND PINES3 SCK PINES4 SDO PINES5 SDI PINES6 CS PINES7 FLT PINES8 DRDY PINES9; 3 JUMPER; OUT OUT GND2 GND2 SCL SCL SDA SDA VCC VCC GND1 GND; RPI3_+5V; RPI3_GND; BUZZER_IN; RELAY_IN1; RELAY_IN2; SPI0_MOSI; SPI0_MISO; SPI0_CLK; SPI0_CS0; SPI0_CS1; I2C_SDA; I2C_SCL; RPI3_+3V; BUZZER_OUT_5V; I2C_SDA_5V; I2C_SCL_5V; THERMO_CS3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
