alelucrod/Perfusion/4.Hardware/perfusion_placa_eagle/projects/Perfusion/Imprimibles/placa5_bottom_mirrored.pdf

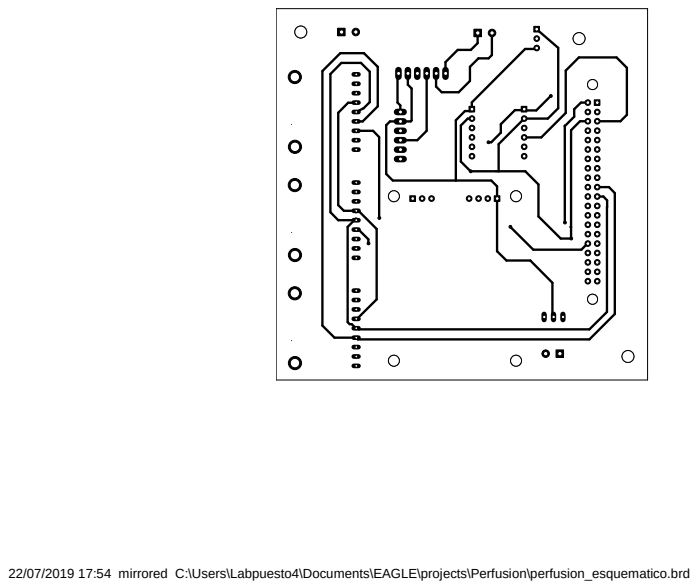
[picture p71: page 1]

22/07/2019 17:54 mirrored C:\Users\Labpuesto4\Documents\EAGLE\projects\Perfusion\perfusion_esquematico.brd
