alelucrod/Perfusion/4.Hardware/perfusion_placa_eagle/projects/Perfusion/Imprimibles/placa5_top.pdf

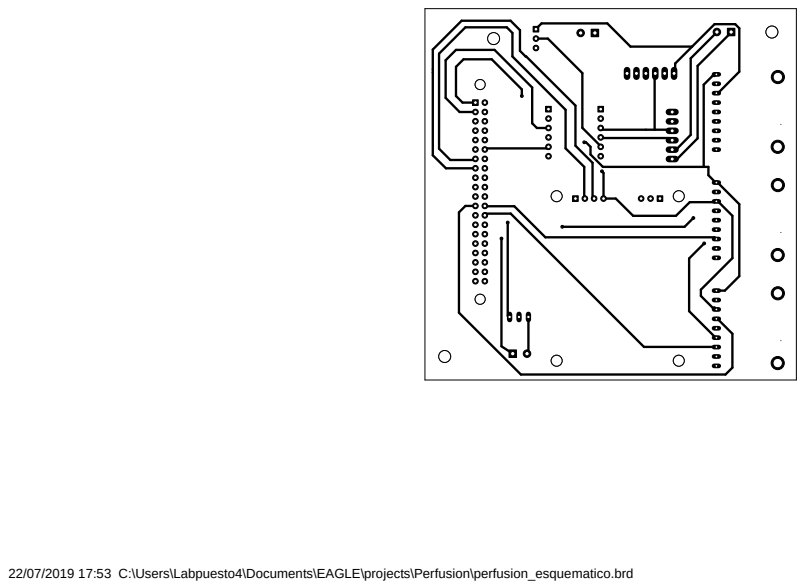
[picture p72: page 1]

22/07/2019 17:53 C:\Users\Labpuesto4\Documents\EAGLE\projects\Perfusion\perfusion_esquematico.brd
