alelucrod/Perfusion/4.Hardware/perfusion_placa_eagle/projects/Perfusion/perfusion_esquematico.brd

## EAGLE design 4.Hardware/perfusion_placa_eagle/projects/Perfusion/perfusion_esquematico.brd (2020-03-28)

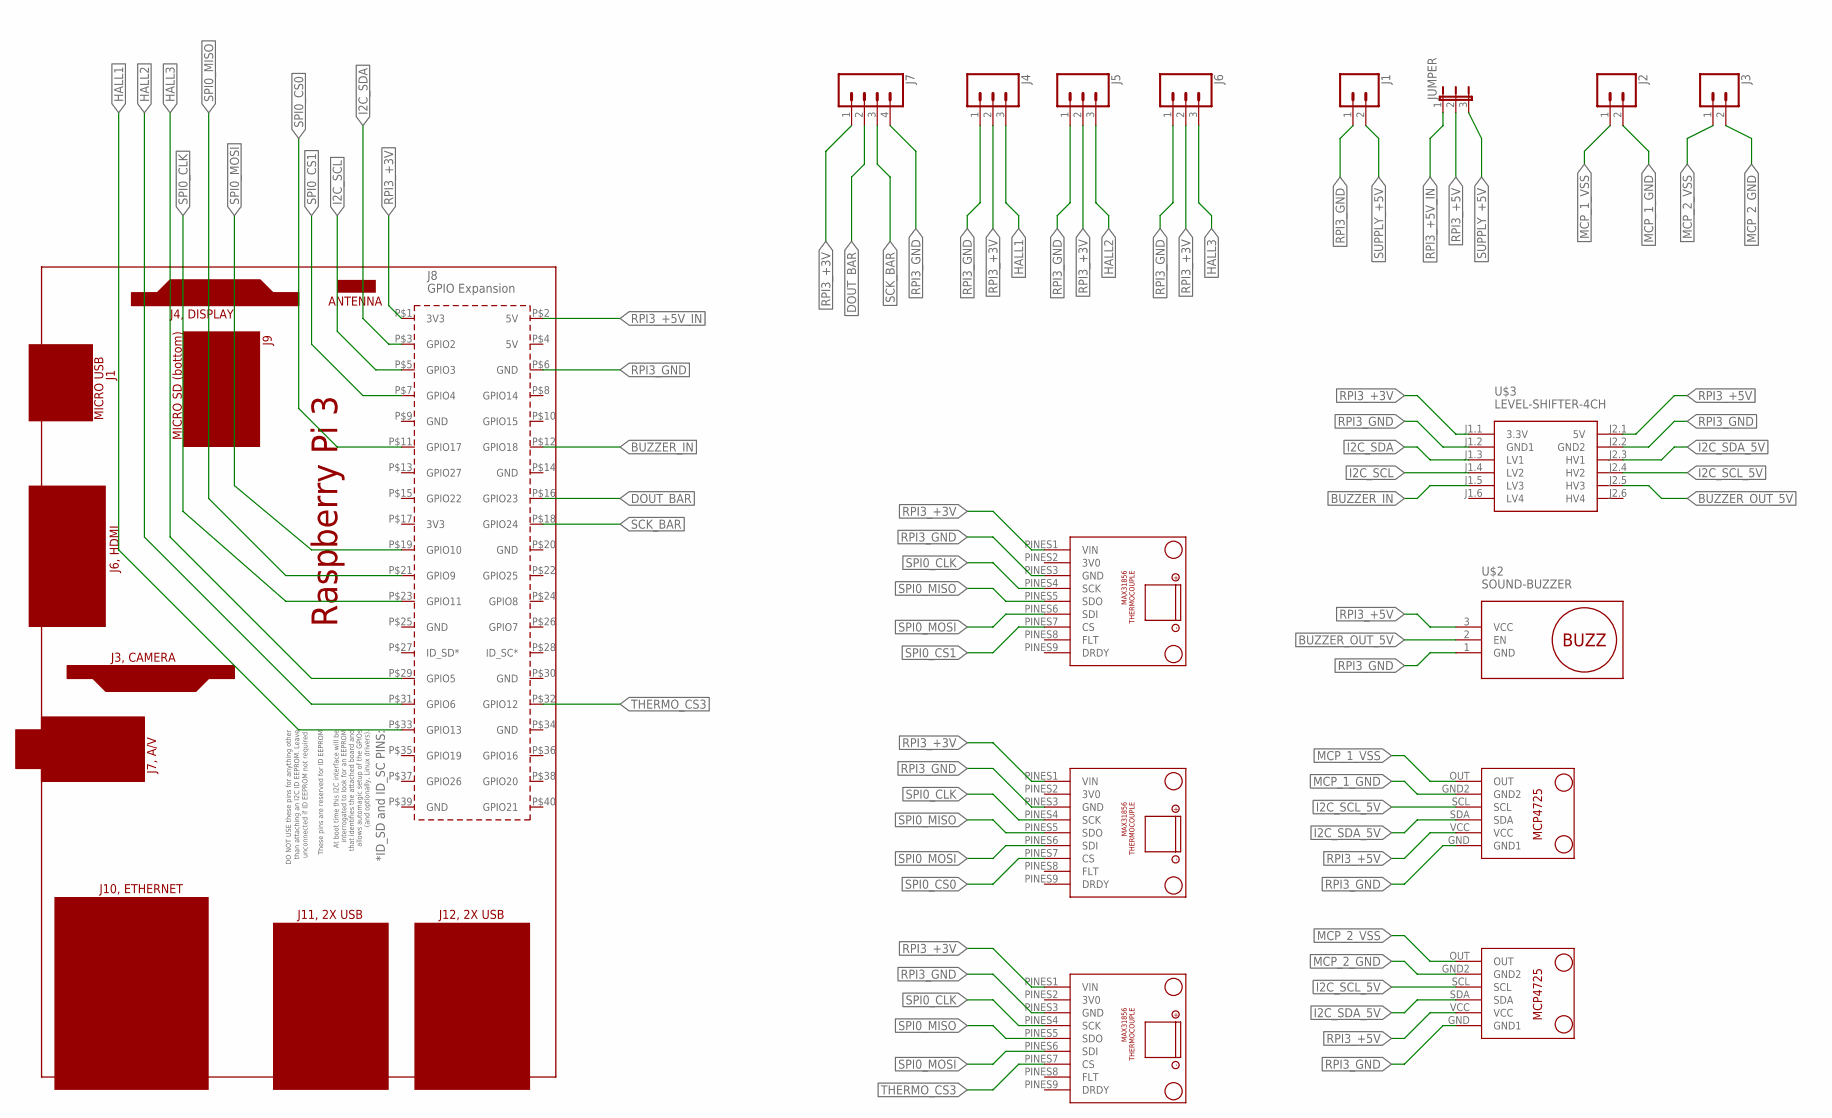
[picture p73: schematic perfusion_esquematico.sch]

Parts:
J1, J2, J3: CONN_023.5MM_LOCK; SCREWTERMINAL-3.5MM-2_LOCK
J4, J5, J6: CONN_03; 1X03
J7: CONN_04LONGPADS; 1X04_LONGPADS
JUMPER: JP2E; JP2
PCB1: RPI3
U$2: SOUND-BUZZER
U$3: LEVEL-SHIFTER-4CH
U$4, U$5, U$6: MAX31856
U$7, U$8: LIB1MCP4725_ABF; LIB1

Connections:
BUZZER_IN: PCB1.P$12 (GPIO18), U$3.J1.5 (LV3)
BUZZER_OUT_5V: U$2.2 (EN), U$3.J2.5 (HV3)
DOUT_BAR: J7.2, PCB1.P$16 (GPIO23)
HALL1: J4.3, PCB1.P$33 (GPIO13)
HALL2: J5.3, PCB1.P$31 (GPIO6)
HALL3: J6.3, PCB1.P$29 (GPIO5)
I2C_SCL: PCB1.P$5 (GPIO3), U$3.J1.4 (LV2)
I2C_SCL_5V: U$3.J2.4 (HV2), U$7.SCL, U$8.SCL
I2C_SDA: PCB1.P$3 (GPIO2), U$3.J1.3 (LV1)
I2C_SDA_5V: U$3.J2.3 (HV1), U$7.SDA, U$8.SDA
MCP_1_GND: J2.2, U$8.GND2
MCP_1_VSS: J2.1, U$8.OUT
MCP_2_GND: J3.2, U$7.GND2
MCP_2_VSS: J3.1, U$7.OUT
RPI3_+3V: J4.2, J5.2, J6.2, J7.1, PCB1.P$1 (3V3), U$3.J1.1 (3.3V), U$4.PINES1 (VIN), U$5.PINES1 (VIN), U$6.PINES1 (VIN)
RPI3_+5V: JUMPER.2, U$2.3 (VCC), U$3.J2.1 (5V), U$7.VCC, U$8.VCC
RPI3_+5V_IN: JUMPER.1, PCB1.P$2 (5V)
RPI3_GND: J1.1, J4.1, J5.1, J6.1, J7.4, PCB1.P$6 (GND), U$2.1 (GND), U$3.J1.2 (GND1), U$3.J2.2 (GND2), U$4.PINES3 (GND), U$5.PINES3 (GND), U$6.PINES3 (GND), U$7.GND (GND1), U$8.GND (GND1)
SCK_BAR: J7.3, PCB1.P$18 (GPIO24)
SPI0_CLK: PCB1.P$23 (GPIO11), U$4.PINES4 (SCK), U$5.PINES4 (SCK), U$6.PINES4 (SCK)
SPI0_CS0: PCB1.P$11 (GPIO17), U$4.PINES7 (CS)
SPI0_CS1: PCB1.P$7 (GPIO4), U$5.PINES7 (CS)
SPI0_MISO: PCB1.P$21 (GPIO9), U$4.PINES5 (SDO), U$5.PINES5 (SDO), U$6.PINES5 (SDO)
SPI0_MOSI: PCB1.P$19 (GPIO10), U$4.PINES6 (SDI), U$5.PINES6 (SDI), U$6.PINES6 (SDI)
SUPPLY_+5V: J1.2, JUMPER.3
THERMO_CS3: PCB1.P$32 (GPIO12), U$6.PINES7 (CS)

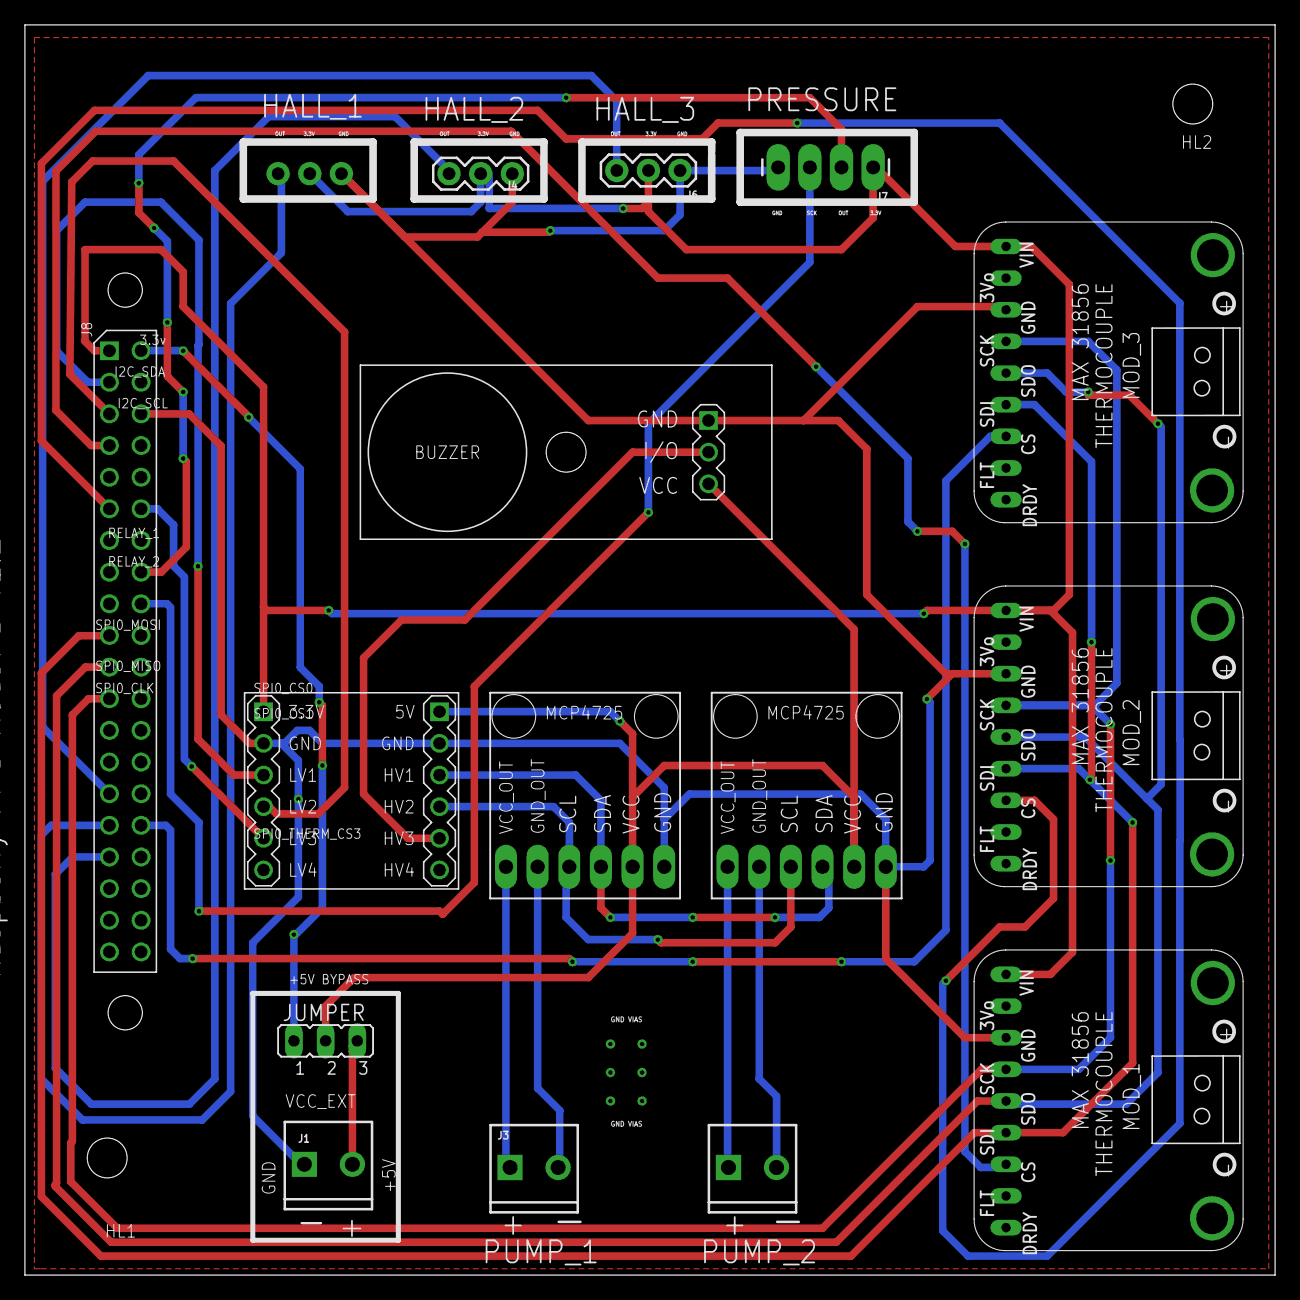
[picture p74: board perfusion_esquematico.brd from above]

Board: 2 copper layers, 100.3 x 100.3 mm, 16 parts (1 on the bottom side), 26 nets.
