alelucrod/Perfusion/(commit log)

2020-02-18 [ADD] Creada estructura de directorios
2020-02-22 [MOD] Agregado los ficheros del proyecto
    [esquematico.brd, esquematico.sch, esquematico2.brd, esquematico2.sch, esquematico3.brd, esquematico3.sch, perfusion_esquematico.brd, perfusion_esquematico.sch]
2020-02-22 [ADD] Añadida borrador de interfaz
2020-02-26 [MOD] Agregada nuevas opciones de seleccion
2020-02-29 [MOD] Reestructuracion + opciones de agregar filas a tabla
2020-03-08 [MOD] interfaz acabada antes de cambios de Ramón
2020-03-17 [MOD] Actualizada la interfaz
2020-03-17 [MOD] Actualizado los nombres de la gui
2020-03-17 [ADD] Test efecto hall
2020-03-18 [ADD] Logos y Modelo 3D soporte
    [Ensamblaje_Modulo_hall.SLDASM, Soporte_hall.SLDPRT, Soporte_hall_acople.SLDPRT, Soporte_hall_modulo.SLDPRT, ensamblajetotal.STL]
2020-03-24 [MOD] Fixes hardware
    [esquematico.brd, esquematico.sch, esquematico2.brd, esquematico2.sch, esquematico3.brd, esquematico3.sch, perfusion_esquematico.brd, perfusion_esquematico.sch]
2020-03-28 [MOD] Interfaz a espera de Ale
